SlightlyDazed/lokogad/docs/images/workflow.png

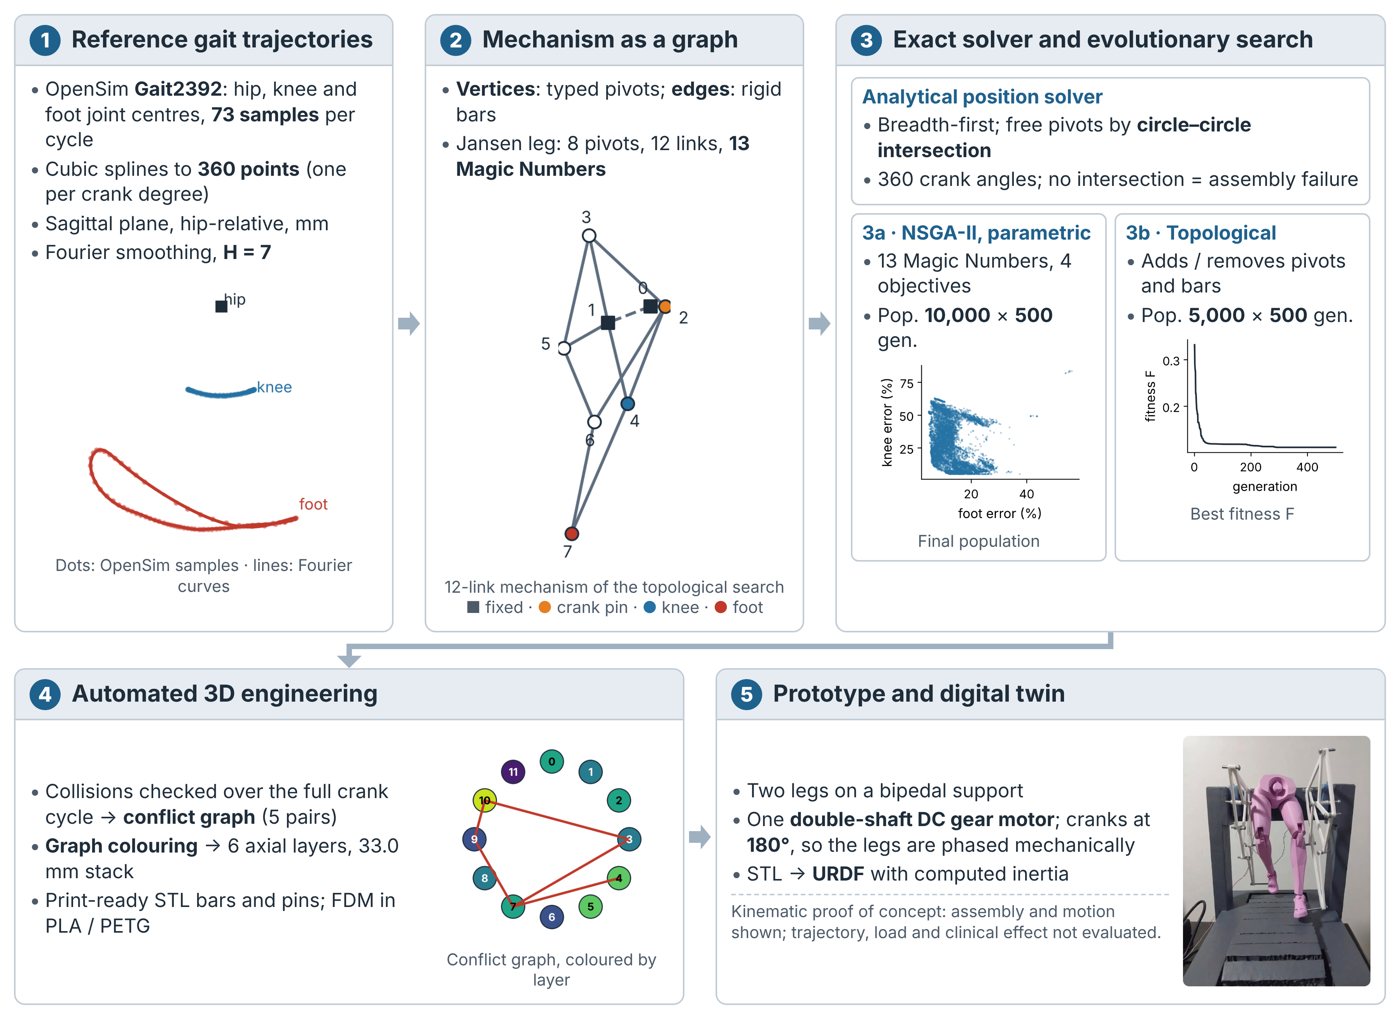
docs/images/workflow.png
