SlightlyDazed/lokogad/mechanism/theo_jansen_animation.gif

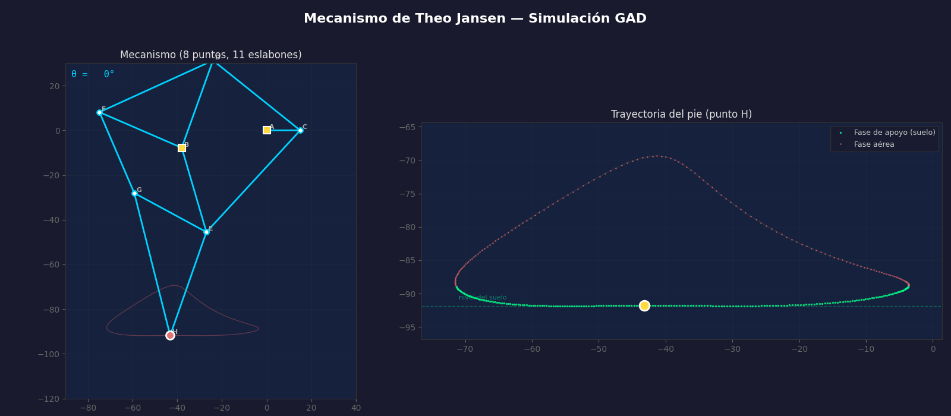
mechanism/theo_jansen_animation.gif
