SlightlyDazed/lokogad/opensim_extraction/gait_foot_trajectory.png

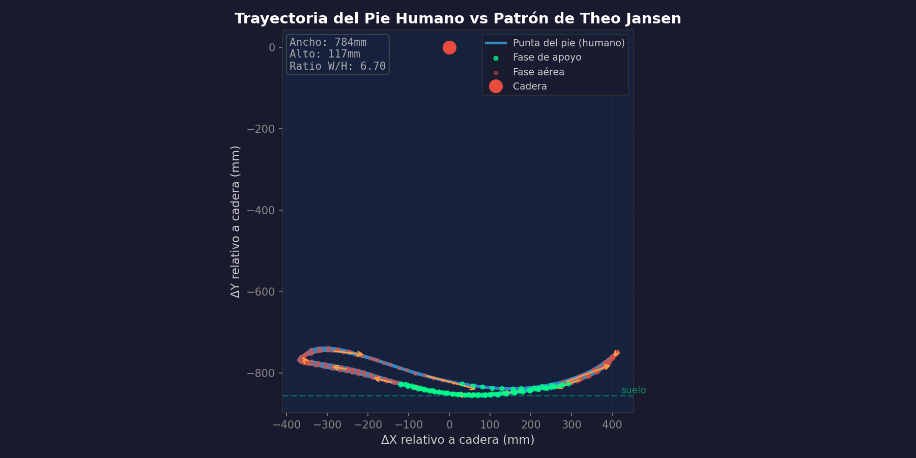
opensim_extraction/gait_foot_trajectory.png
