SlightlyDazed/lokogad/opensim_extraction/gait_spatial_trajectories.png

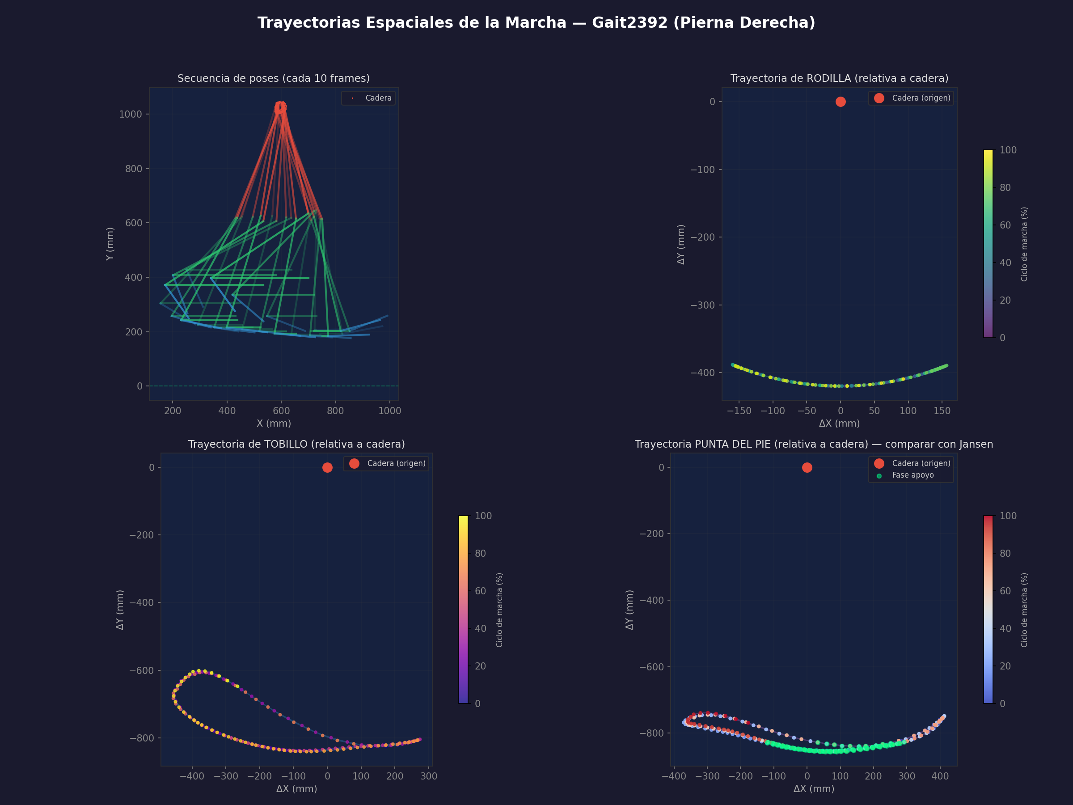
opensim_extraction/gait_spatial_trajectories.png
