SlightlyDazed/lokogad/opensim_extraction/gait_trajectories.png

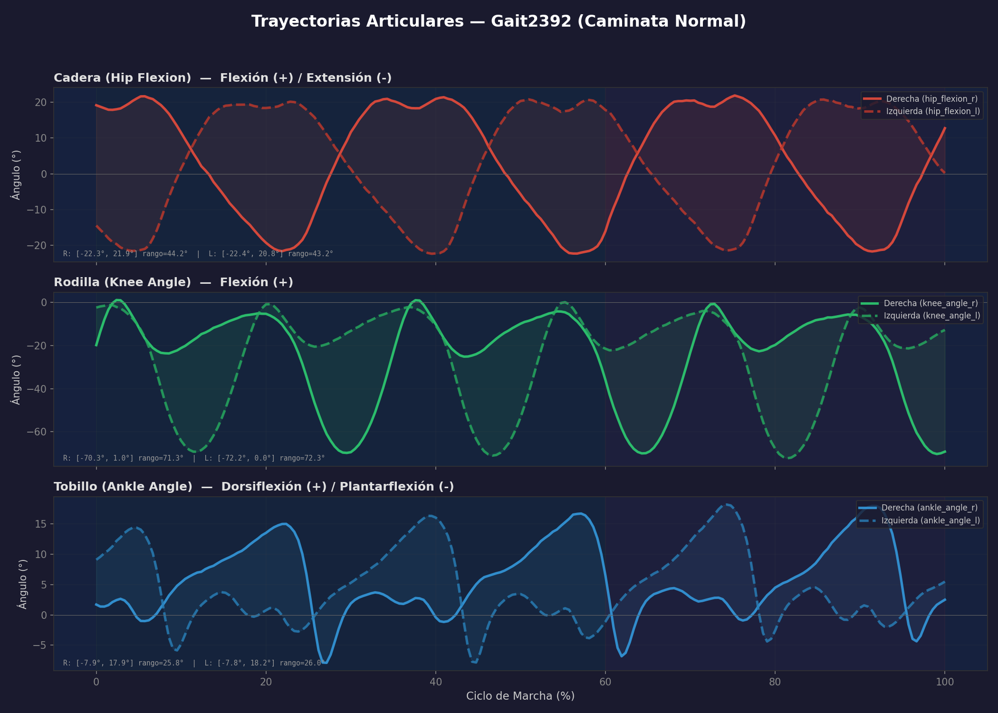
opensim_extraction/gait_trajectories.png
