SlightlyDazed/lokogad/results/paper_figures/fig2_magic_numbers.png

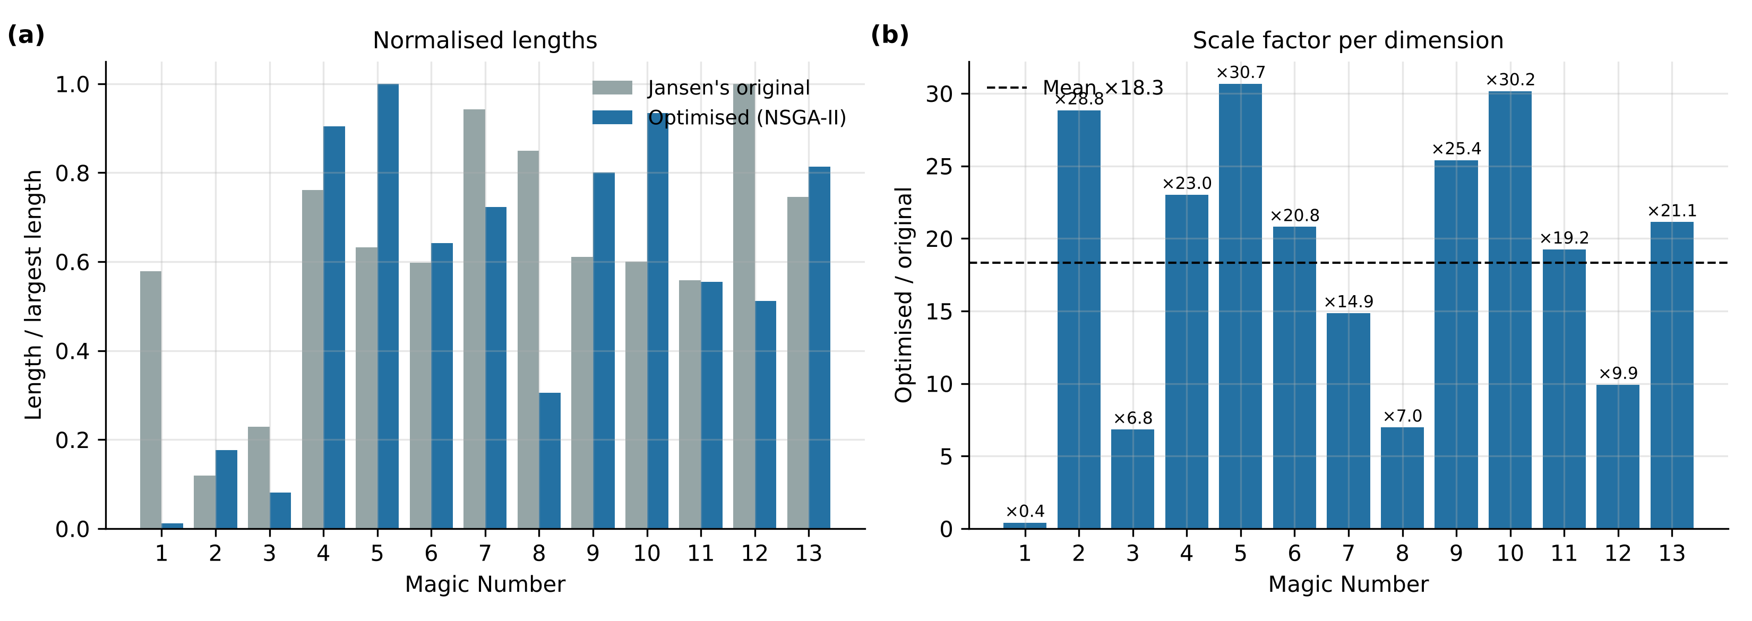
results/paper_figures/fig2_magic_numbers.png
