SlightlyDazed/lokogad/results/paper_figures/fig3_pareto_front.png

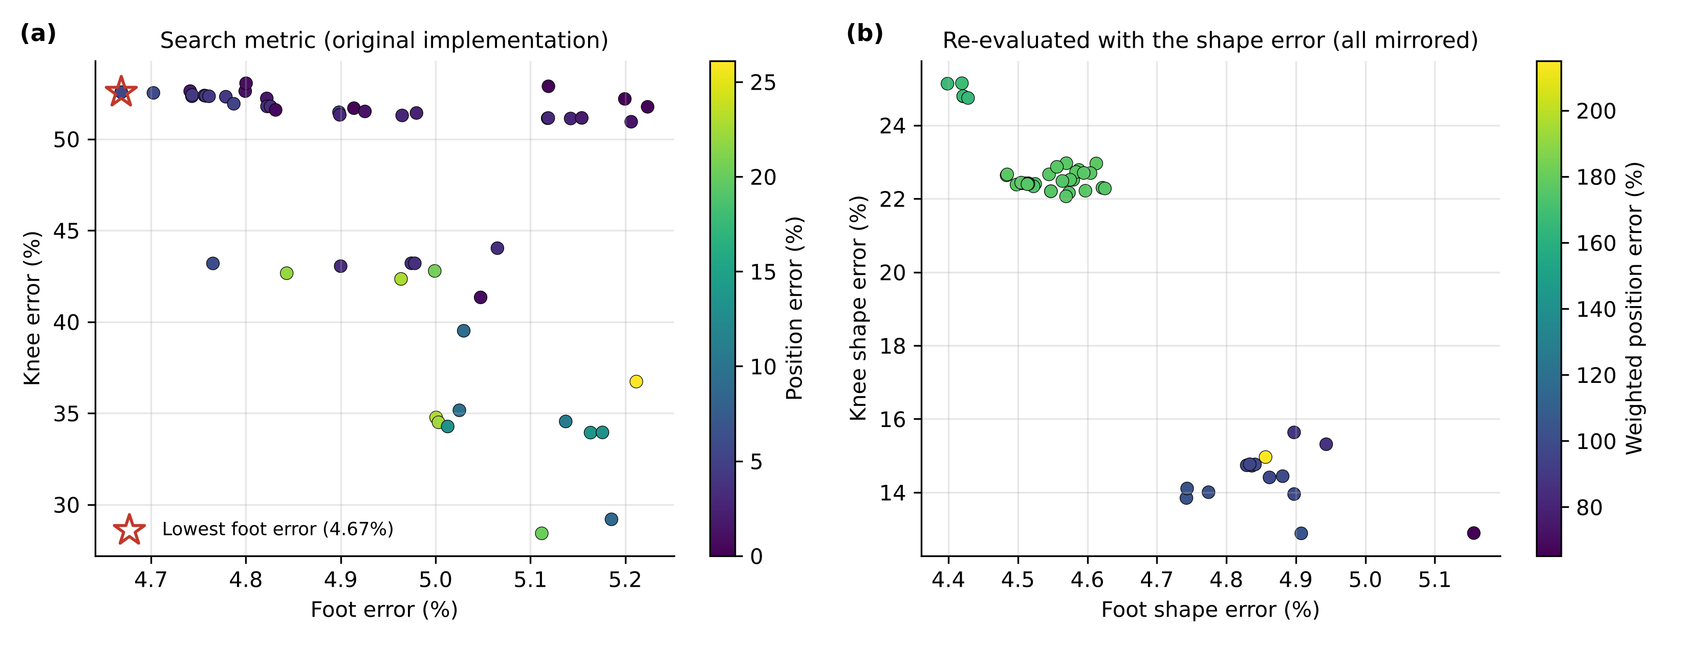
results/paper_figures/fig3_pareto_front.png
