SlightlyDazed/lokogad/results/paper_figures/fig4_z_layers.png

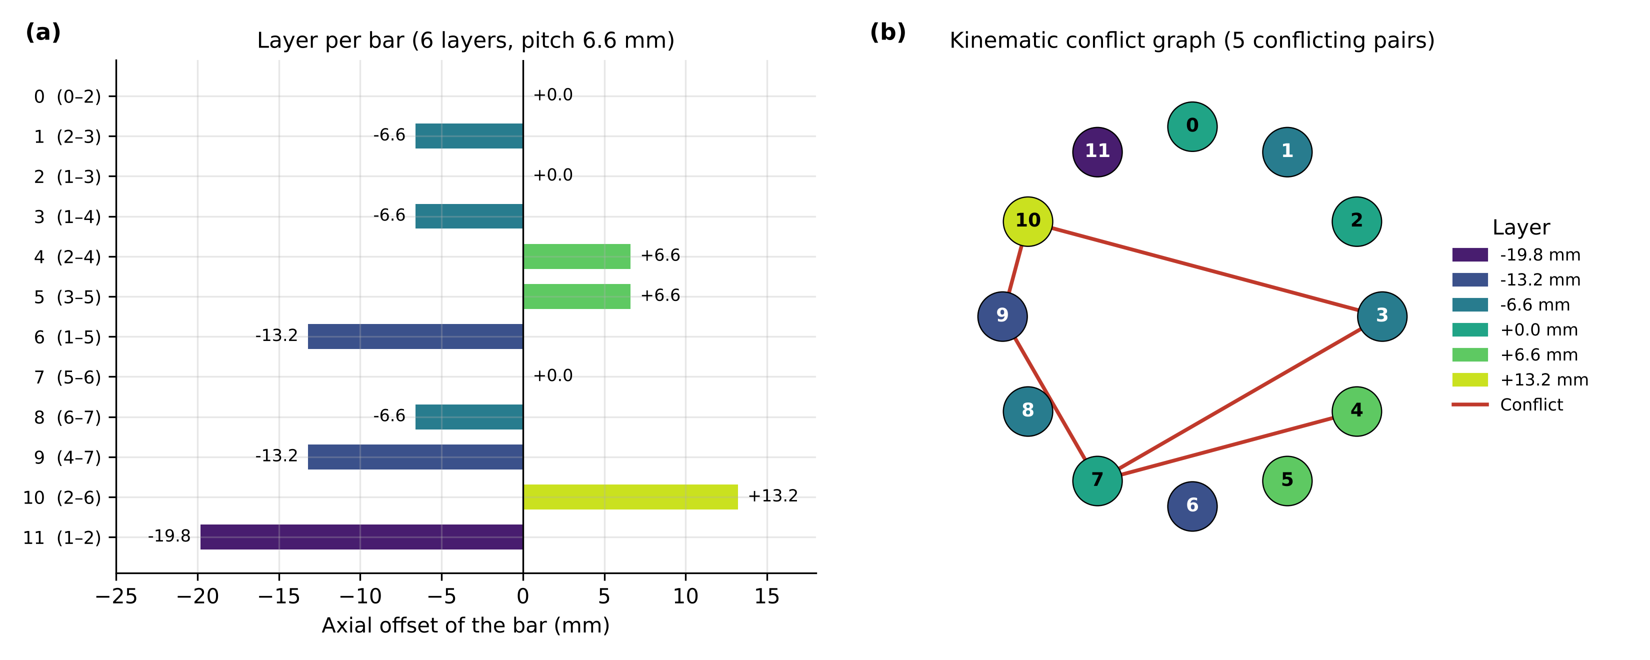
results/paper_figures/fig4_z_layers.png
