SlightlyDazed/lokogad/results/paper_figures/fig_gait_sequence_3d.png

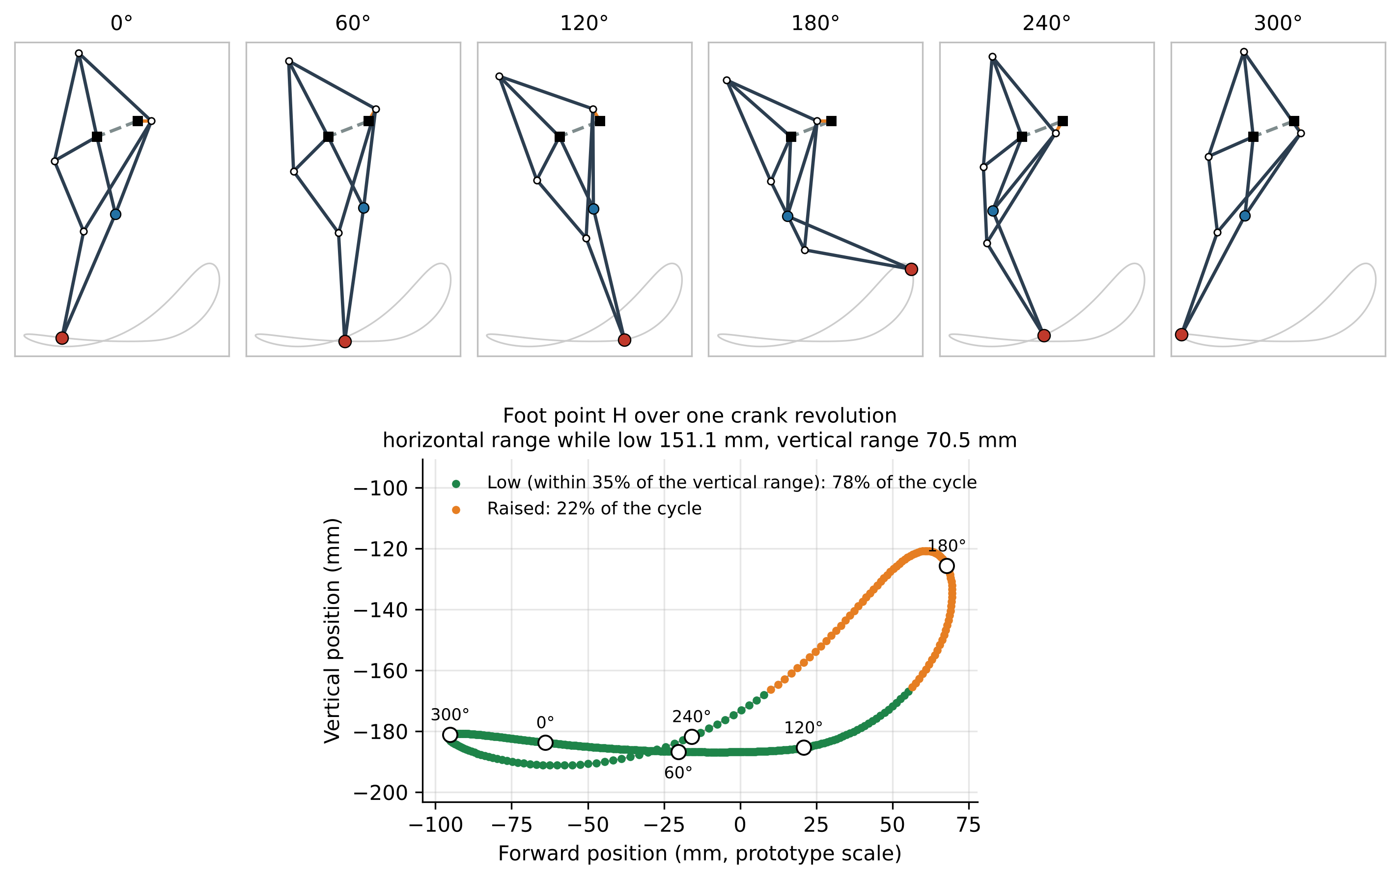
results/paper_figures/fig_gait_sequence_3d.png
