SlightlyDazed/lokogad/results/paper_figures/figconvergence.png

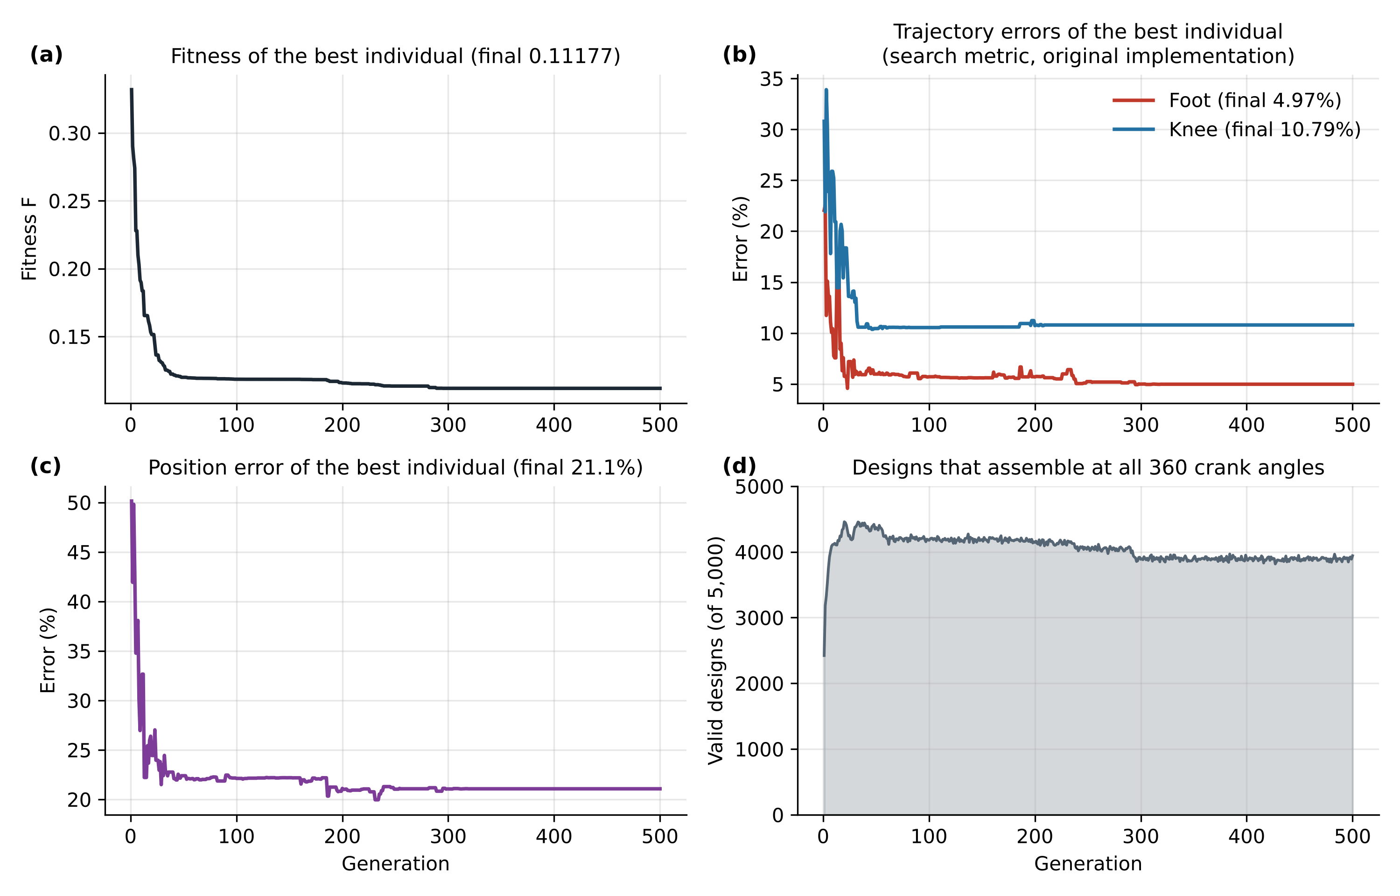
results/paper_figures/figconvergence.png
