SlightlyDazed/lokogad/snap_joint/snap_joint_assembly.step

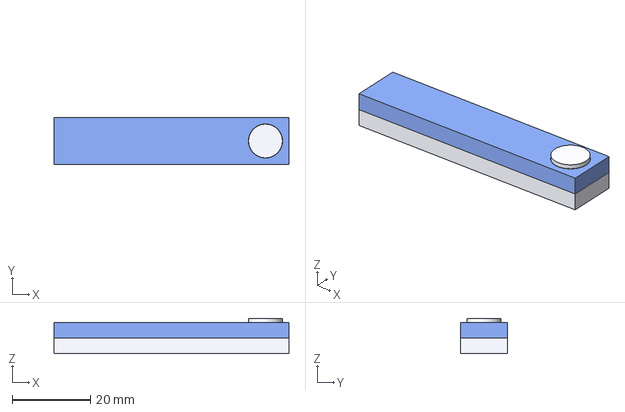
[picture p34: CAD file, 2026-10-27]
snap_joint/snap_joint_assembly.step
60.0 x 12.0 x 9.00 mm
link_A
link_B
