SlightlyDazed/lokogad/mechanism/meshes/link_DF.step

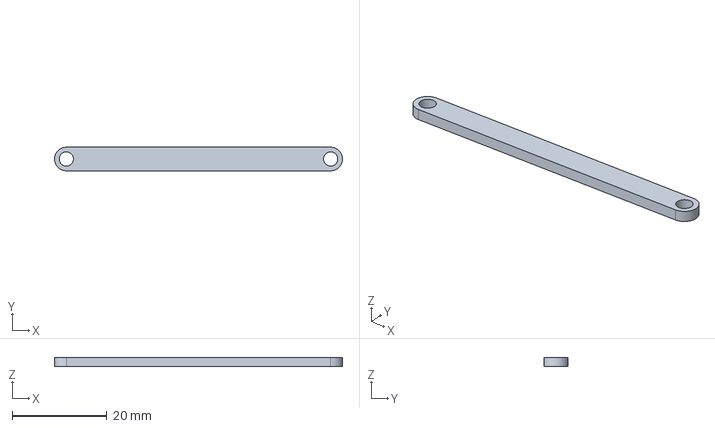
[picture p35: CAD file, 2026-10-27]
mechanism/meshes/link_DF.step
60.8 x 5.00 x 2.00 mm
