SlightlyDazed/lokogad/results/exported/candidate_001/meshes/crank.step

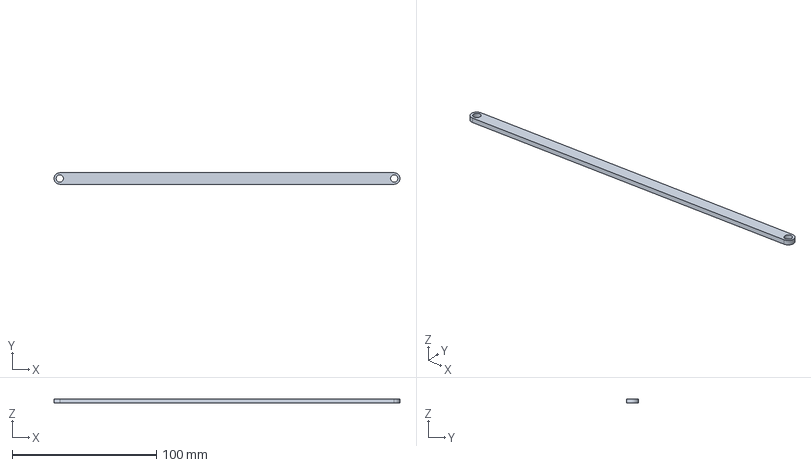
[picture p36: CAD file, 2026-10-27]
results/exported/candidate_001/meshes/crank.step
239.5 x 8.00 x 3.00 mm
