SlightlyDazed/lokogad/results/exported/candidate_002/meshes/crank.step

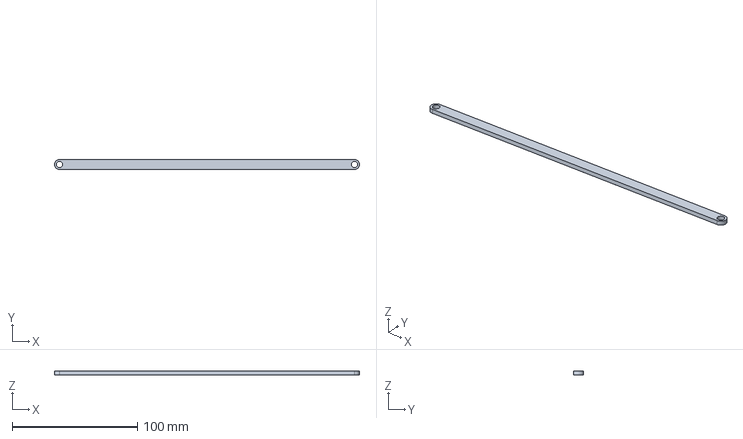
[picture p37: CAD file, 2026-10-27]
results/exported/candidate_002/meshes/crank.step
243.2 x 8.00 x 3.00 mm
