SlightlyDazed/lokogad/results/exported/candidate_003/meshes/link_FG.step

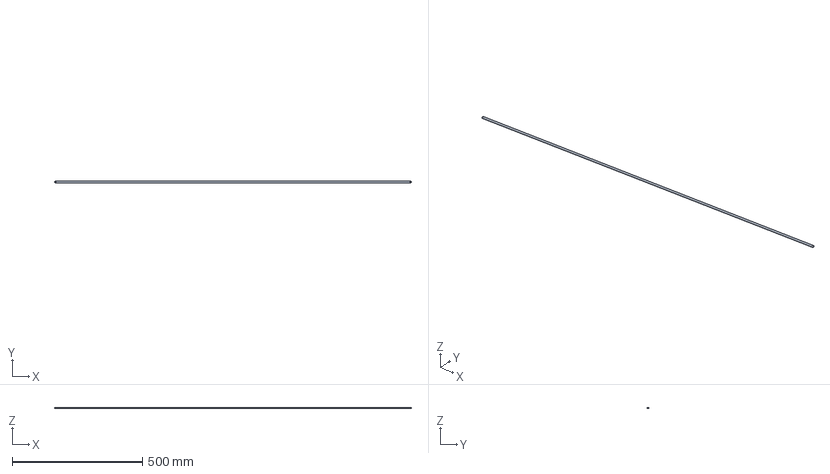
[picture p38: CAD file, 2026-10-27]
results/exported/candidate_003/meshes/link_FG.step
1368.1 x 8.00 x 3.00 mm
