SlightlyDazed/lokogad/results/exported/candidate_004/meshes/link_BF.step

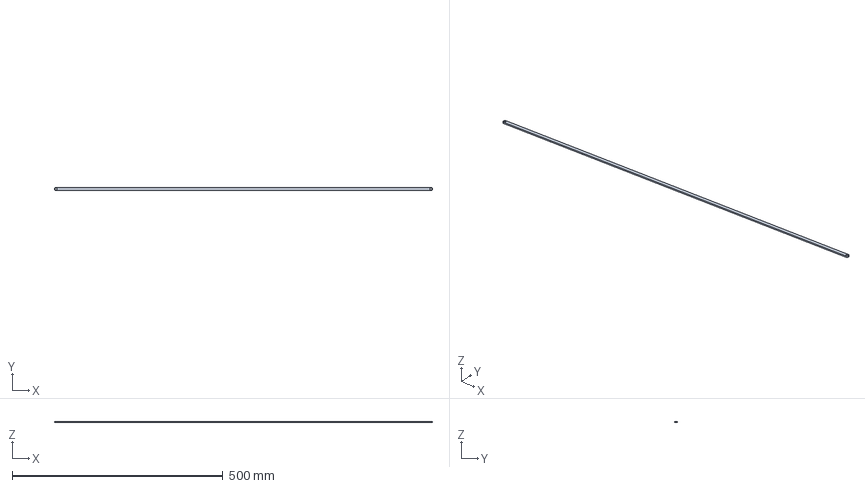
[picture p39: CAD file, 2026-10-27]
results/exported/candidate_004/meshes/link_BF.step
897.1 x 8.00 x 3.00 mm
