SlightlyDazed/lokogad/results/exported/candidate_005/meshes/chassis.step

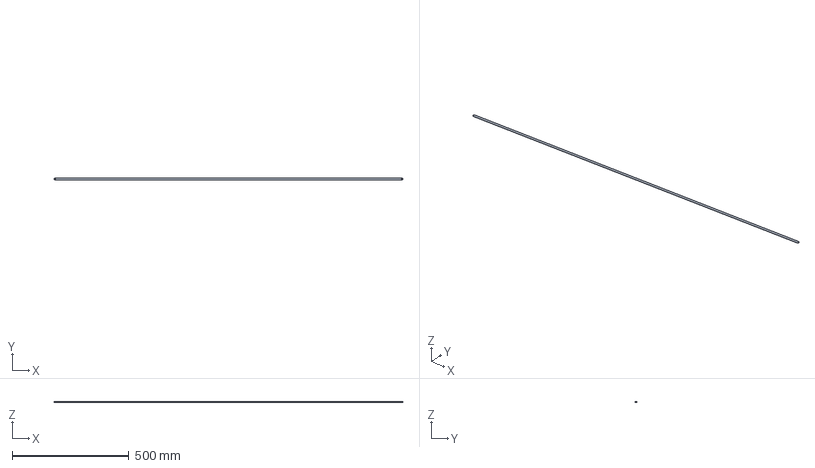
[picture p40: CAD file, 2026-10-27]
results/exported/candidate_005/meshes/chassis.step
1493.4 x 8.00 x 3.00 mm
