SlightlyDazed/lokogad/results/stl_for_print/barras_redim_1.25x/BARRA_06__N1-N5__52mm__capa-2_ESCALADA_1.25x.stl

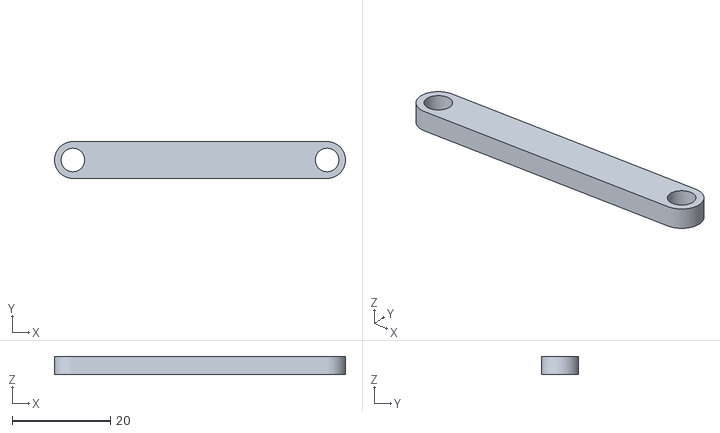
[picture p41: CAD file, 2026-10-27]
results/stl_for_print/barras_redim_1.25x/BARRA_06__N1-N5__52mm__capa-2_ESCALADA_1.25x.stl
59.3 x 7.50 x 3.75
