SlightlyDazed/lokogad/results/stl_for_print/evolved_thick/pin_01_ground_h82mm_z+0mm.stl

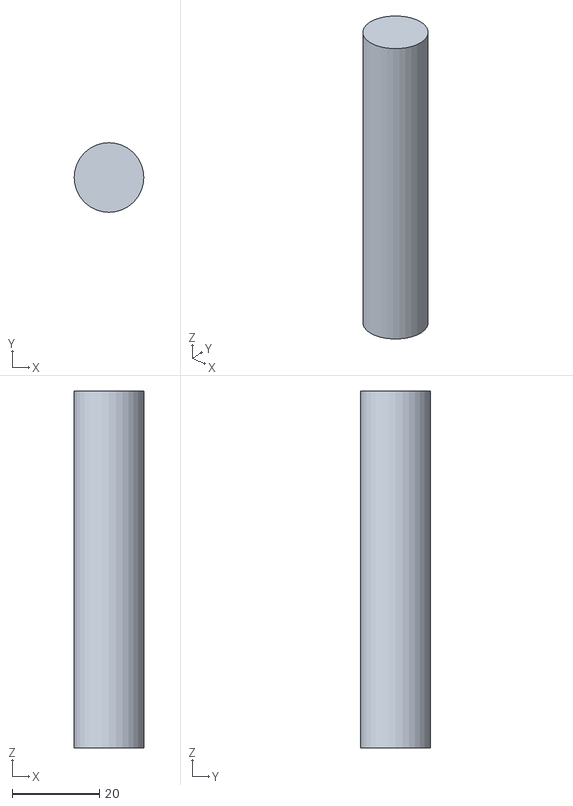
[picture p42: CAD file, 2026-10-27]
results/stl_for_print/evolved_thick/pin_01_ground_h82mm_z+0mm.stl
16.0 x 16.0 x 82.0
