SlightlyDazed/lokogad/results/stl_for_print/print_ready_250mm/PIN_05__libre__h23mm.stl

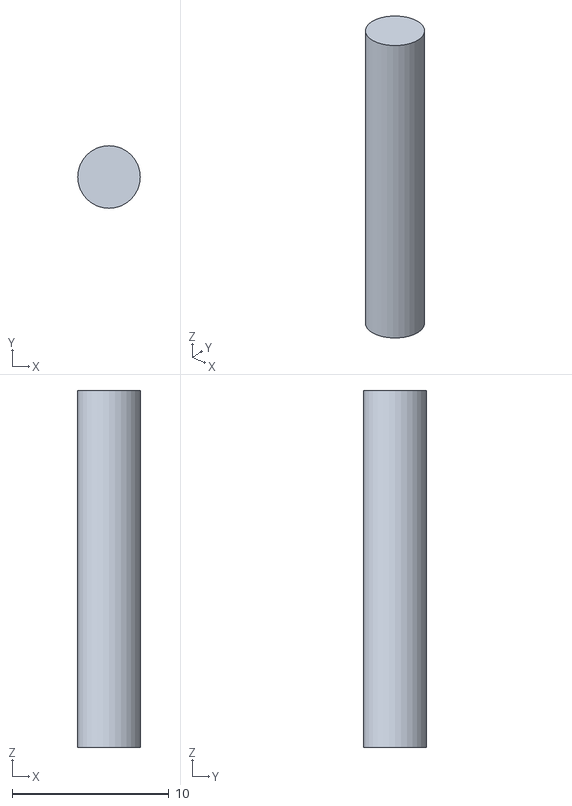
[picture p43: CAD file, 2026-10-27]
results/stl_for_print/print_ready_250mm/PIN_05__libre__h23mm.stl
4.00 x 4.00 x 22.8
