SlightlyDazed/lokogad/snap_joint/link_A.step

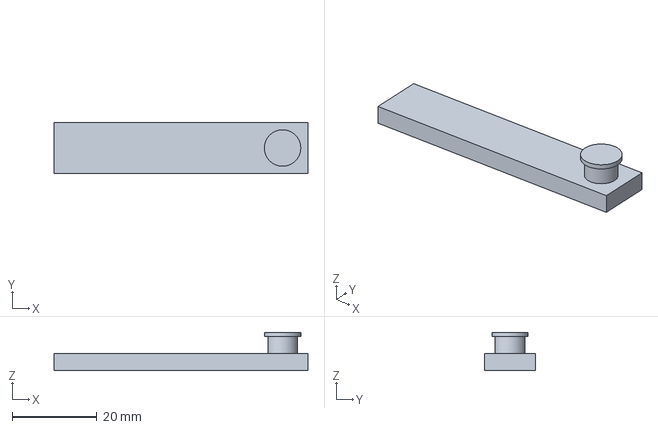
[picture p44: CAD file, 2026-10-27]
snap_joint/link_A.step
60.0 x 12.0 x 9.00 mm
