SlightlyDazed/lokogad/mechanism/meshes/link_BE.step

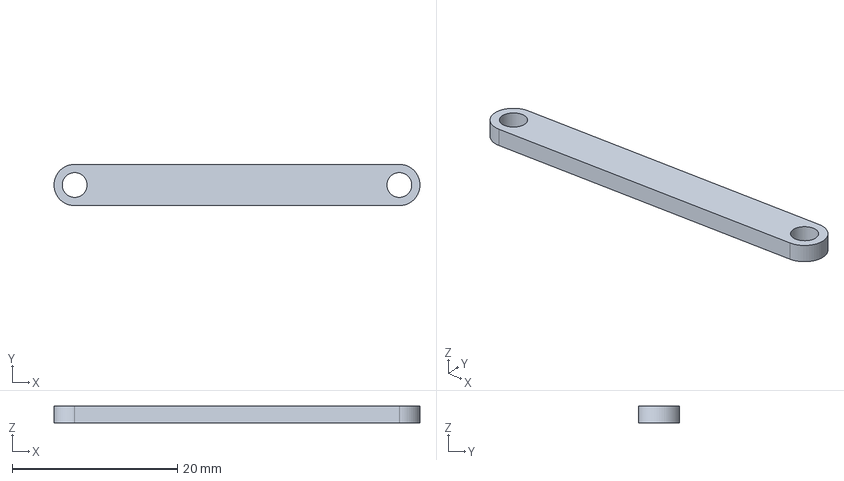
[picture p45: CAD file, 2026-10-27]
mechanism/meshes/link_BE.step
44.3 x 5.00 x 2.00 mm
