SlightlyDazed/lokogad/results/exported/candidate_001/meshes/link_FG.step

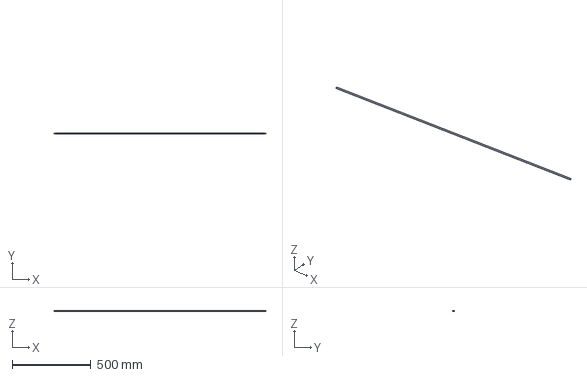
[picture p46: CAD file, 2026-10-27]
results/exported/candidate_001/meshes/link_FG.step
1348.0 x 8.00 x 3.00 mm
