SlightlyDazed/lokogad/results/exported/candidate_003/meshes/link_BF.step

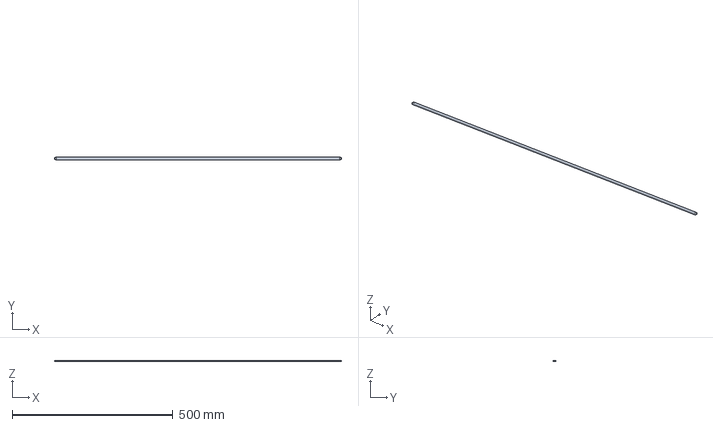
[picture p47: CAD file, 2026-10-27]
results/exported/candidate_003/meshes/link_BF.step
892.2 x 8.00 x 3.00 mm
