SlightlyDazed/lokogad/results/exported/candidate_004/meshes/link_CE.step

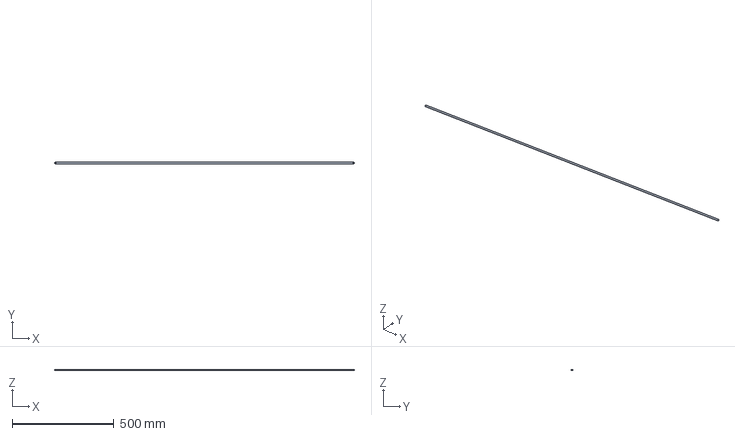
[picture p48: CAD file, 2026-10-27]
results/exported/candidate_004/meshes/link_CE.step
1475.8 x 8.00 x 3.00 mm
