SlightlyDazed/lokogad/results/exported/candidate_005/meshes/link_DF.step

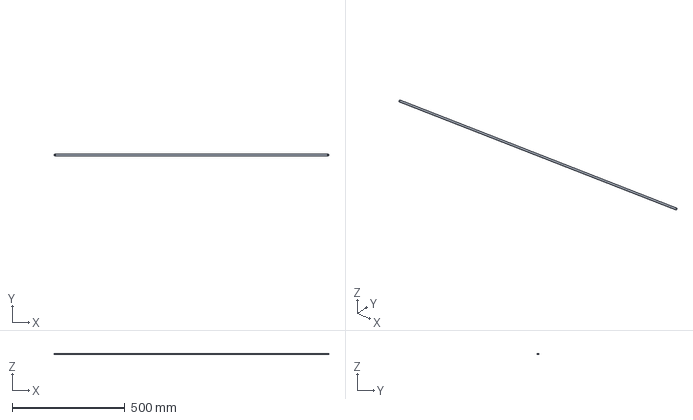
[picture p49: CAD file, 2026-10-27]
results/exported/candidate_005/meshes/link_DF.step
1221.2 x 8.00 x 3.00 mm
