SlightlyDazed/lokogad/results/stl_for_print/barras_redim_1.25x/BARRA_01__N2-N3__105mm__capa-1_ESCALADA_1.25x.stl

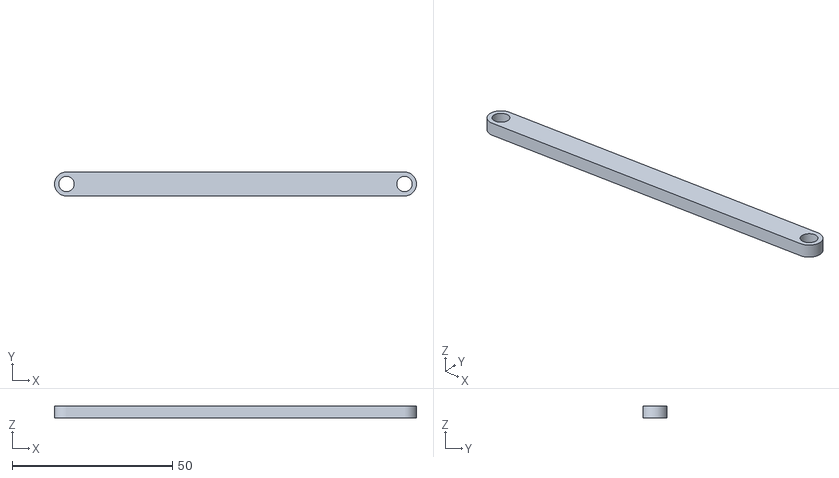
[picture p50: CAD file, 2026-10-27]
results/stl_for_print/barras_redim_1.25x/BARRA_01__N2-N3__105mm__capa-1_ESCALADA_1.25x.stl
112.8 x 7.50 x 3.75
