SlightlyDazed/lokogad/results/stl_for_print/evolved_thick/bar_01_n2-n3_L492mm_z-18mm.stl

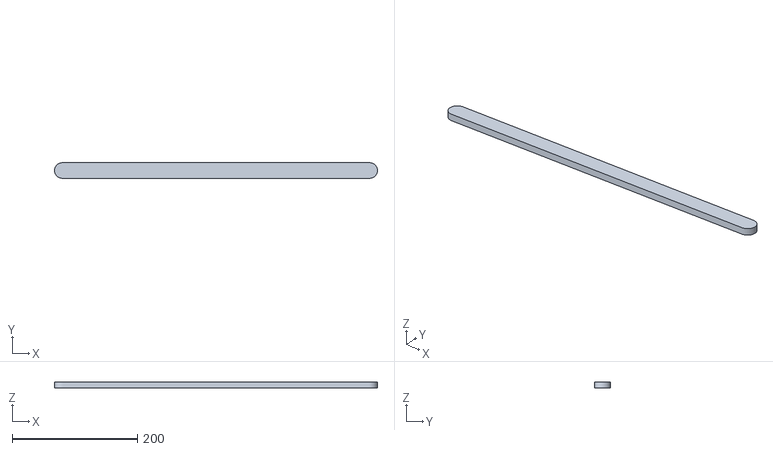
[picture p51: CAD file, 2026-10-27]
results/stl_for_print/evolved_thick/bar_01_n2-n3_L492mm_z-18mm.stl
516.6 x 25.0 x 10.0
