SlightlyDazed/lokogad/results/stl_for_print/print_ready_250mm/PIN_07__pie_efector__h10mm.stl

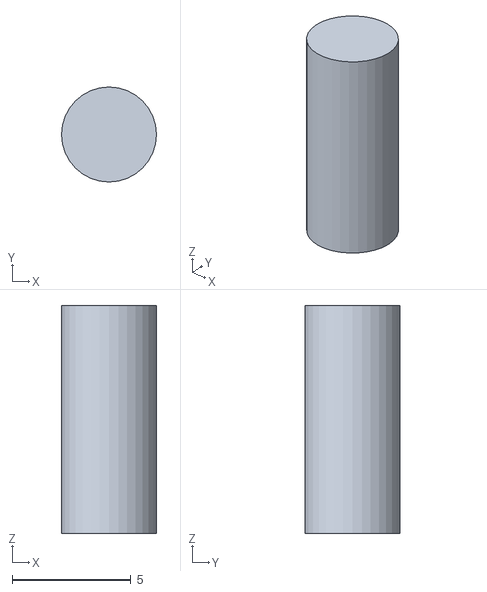
[picture p52: CAD file, 2026-10-27]
results/stl_for_print/print_ready_250mm/PIN_07__pie_efector__h10mm.stl
4.00 x 4.00 x 9.60
