SlightlyDazed/lokogad/snap_joint/link_B.step

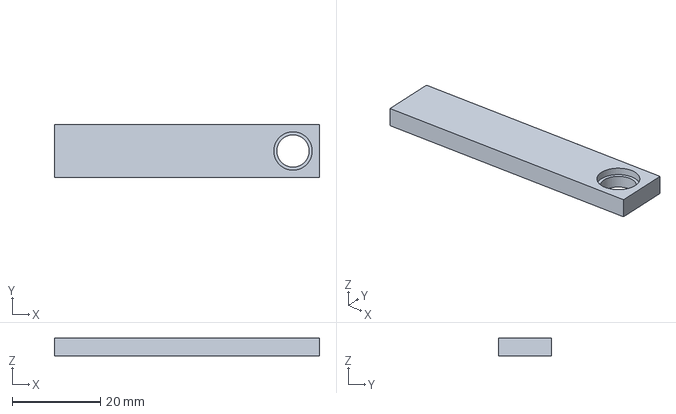
[picture p53: CAD file, 2026-10-27]
snap_joint/link_B.step
60.0 x 12.0 x 4.00 mm
