SlightlyDazed/lokogad/mechanism/meshes/link_CD.step

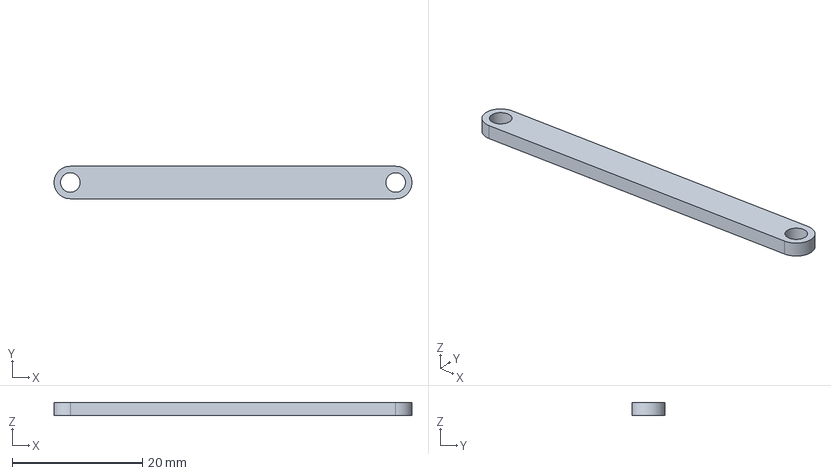
[picture p54: CAD file, 2026-10-27]
mechanism/meshes/link_CD.step
55.0 x 5.00 x 2.00 mm
