SlightlyDazed/lokogad/results/stl_for_print/barras_redim_1.25x/BARRA_10__N2-N6__137mm__capa+2_ESCALADA_1.25x.stl

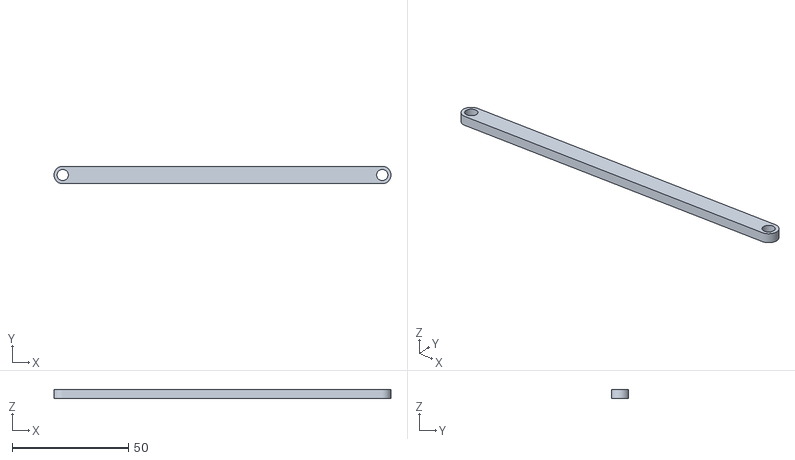
[picture p55: CAD file, 2026-10-27]
results/stl_for_print/barras_redim_1.25x/BARRA_10__N2-N6__137mm__capa+2_ESCALADA_1.25x.stl
144.7 x 7.50 x 3.75
