SlightlyDazed/lokogad/results/stl_for_print/evolved_thick/pin_04_output_knee_h46mm_z+0mm.stl

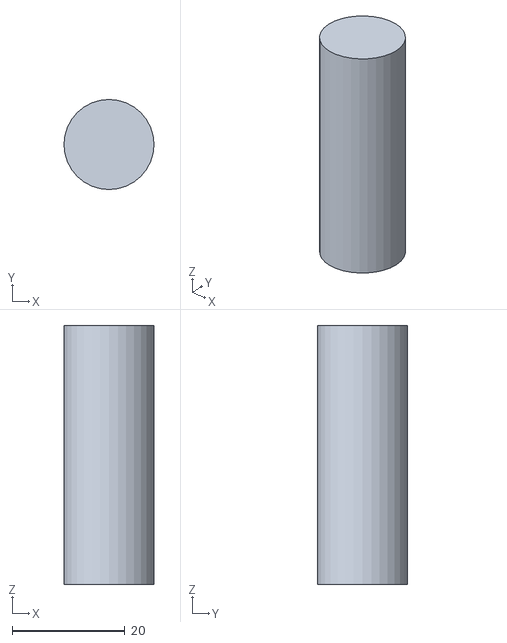
[picture p56: CAD file, 2026-10-27]
results/stl_for_print/evolved_thick/pin_04_output_knee_h46mm_z+0mm.stl
16.0 x 16.0 x 46.0
