SlightlyDazed/lokogad/results/stl_for_print/print_ready_250mm/BARRA_11__N1-N2__18mm__capa-3_ESCALADA_0.6cm.stl

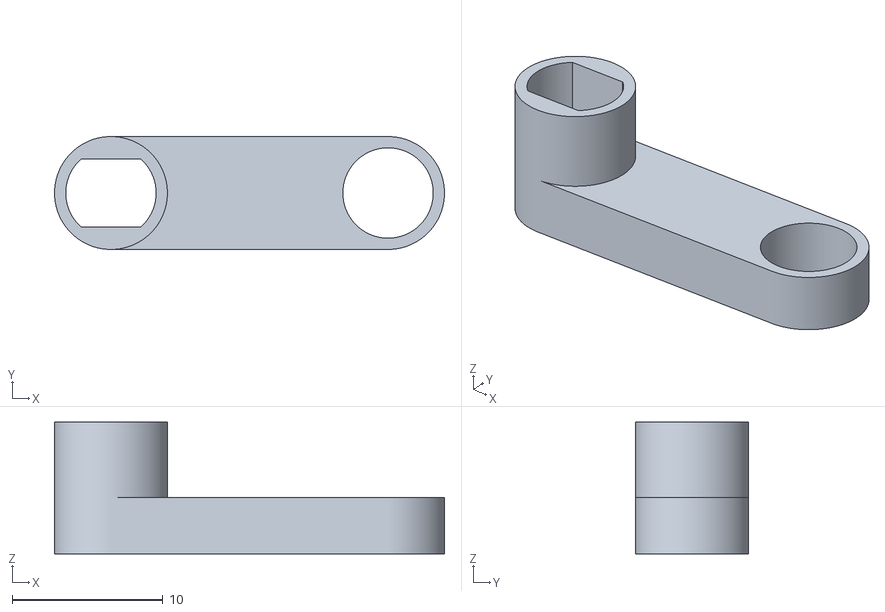
[picture p57: CAD file, 2026-10-27]
results/stl_for_print/print_ready_250mm/BARRA_11__N1-N2__18mm__capa-3_ESCALADA_0.6cm.stl
25.9 x 7.50 x 8.75
