SlightlyDazed/lokogad/mechanism/meshes/crank_AC.step

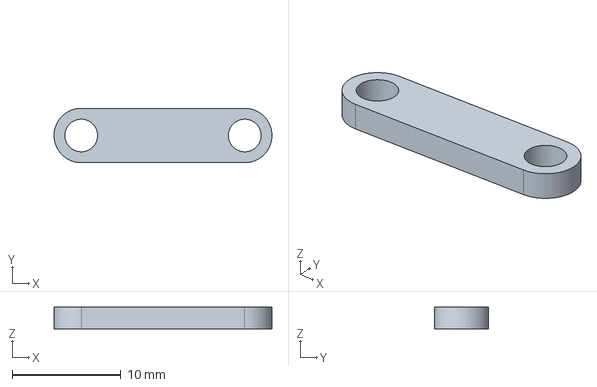
[picture p58: CAD file, 2026-10-27]
mechanism/meshes/crank_AC.step
20.0 x 5.00 x 2.00 mm
