SlightlyDazed/lokogad/results/exported/candidate_004/meshes/link_BE.step

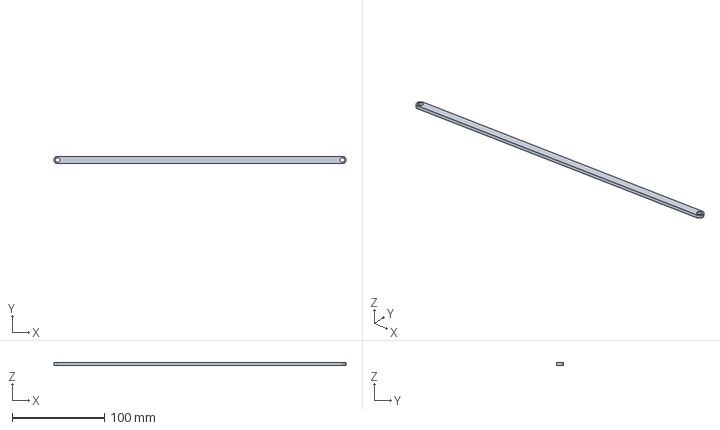
[picture p59: CAD file, 2026-10-27]
results/exported/candidate_004/meshes/link_BE.step
316.8 x 8.00 x 3.00 mm
