SlightlyDazed/lokogad/results/exported/candidate_005/meshes/link_EG.step

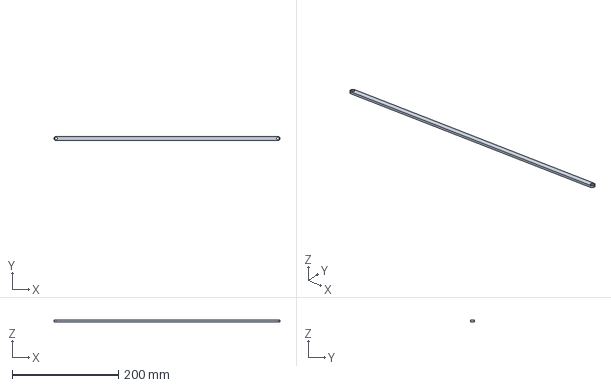
[picture p60: CAD file, 2026-10-27]
results/exported/candidate_005/meshes/link_EG.step
424.5 x 8.00 x 3.00 mm
