SlightlyDazed/lokogad/results/stl_for_print/barras_redim_1.25x/BARRA_02__N1-N3__91mm__capa+0_ESCALADA_1.25x.stl

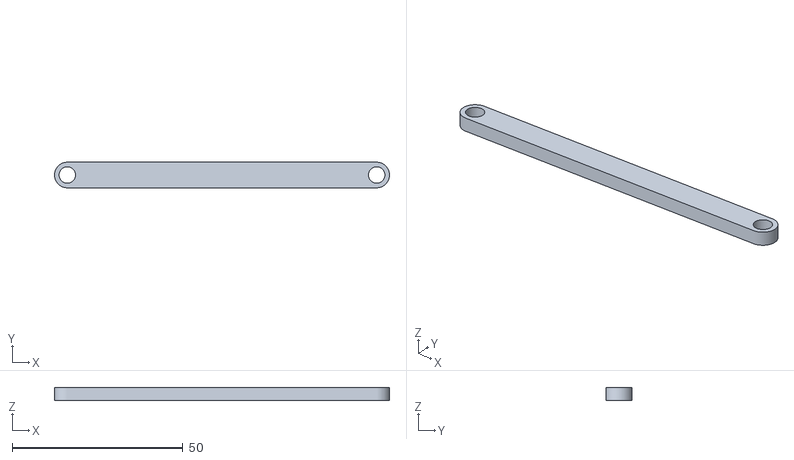
[picture p61: CAD file, 2026-10-27]
results/stl_for_print/barras_redim_1.25x/BARRA_02__N1-N3__91mm__capa+0_ESCALADA_1.25x.stl
98.1 x 7.50 x 3.75
