SlightlyDazed/lokogad/mechanism/meshes/link_GH.step

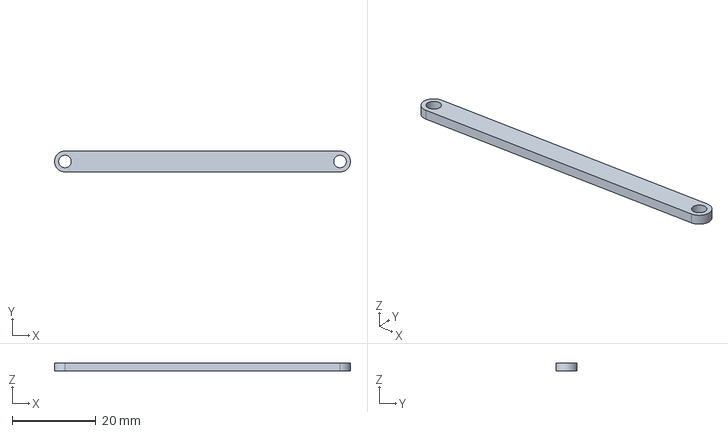
[picture p62: CAD file, 2026-10-27]
mechanism/meshes/link_GH.step
70.7 x 5.00 x 2.00 mm
