SlightlyDazed/lokogad/results/exported/candidate_003/meshes/link_EG.step

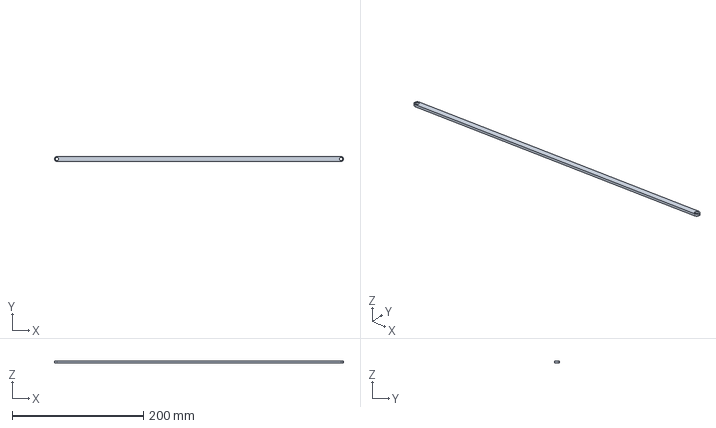
[picture p63: CAD file, 2026-10-27]
results/exported/candidate_003/meshes/link_EG.step
440.1 x 8.00 x 3.00 mm
