SlightlyDazed/lokogad/results/stl_for_print/barras_redim_1.25x/BARRA_00__N0-N2__16mm__capa+0_ESCALADA_1.25x.stl

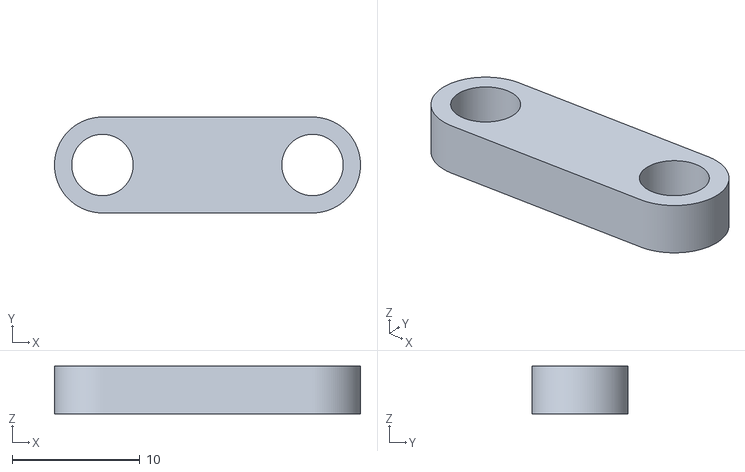
[picture p64: CAD file, 2026-10-27]
results/stl_for_print/barras_redim_1.25x/BARRA_00__N0-N2__16mm__capa+0_ESCALADA_1.25x.stl
23.9 x 7.50 x 3.75
