SlightlyDazed/lokogad/results/stl_for_print/evolved_thick/pin_07_output_foot_h28mm_z-9mm.stl

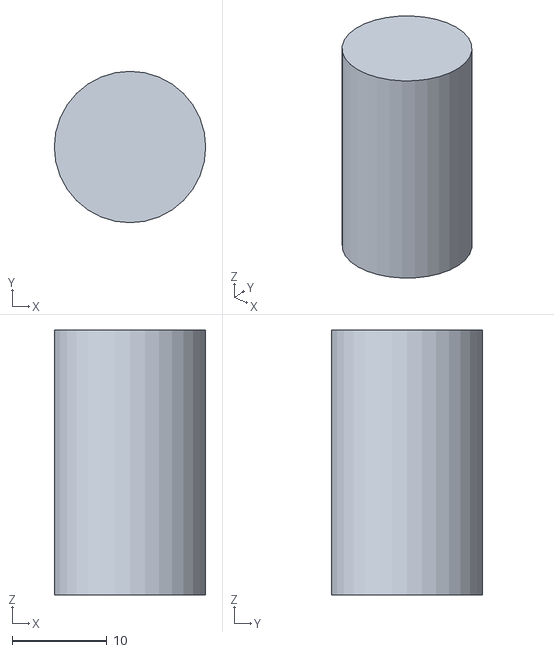
[picture p65: CAD file, 2026-10-27]
results/stl_for_print/evolved_thick/pin_07_output_foot_h28mm_z-9mm.stl
16.0 x 16.0 x 28.0
