SlightlyDazed/lokogad/results/stl_for_print/print_ready_250mm/PIN_03__libre__h16mm.stl

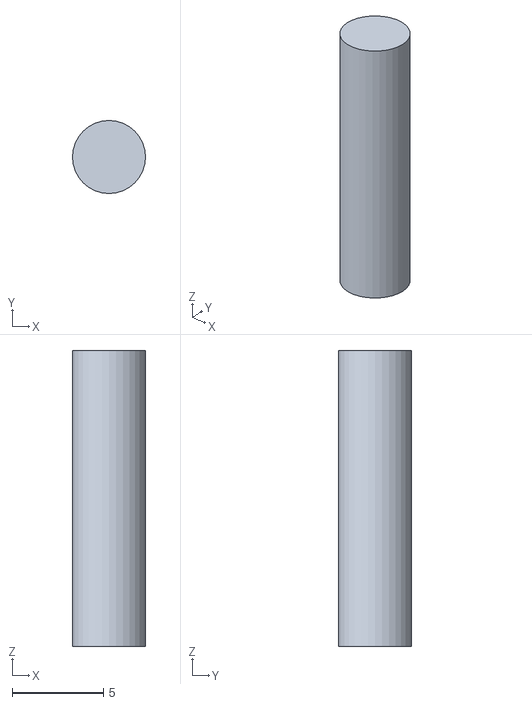
[picture p66: CAD file, 2026-10-27]
results/stl_for_print/print_ready_250mm/PIN_03__libre__h16mm.stl
4.00 x 4.00 x 16.2
