SlightlyDazed/lokogad/mechanism/meshes/link_BF.step

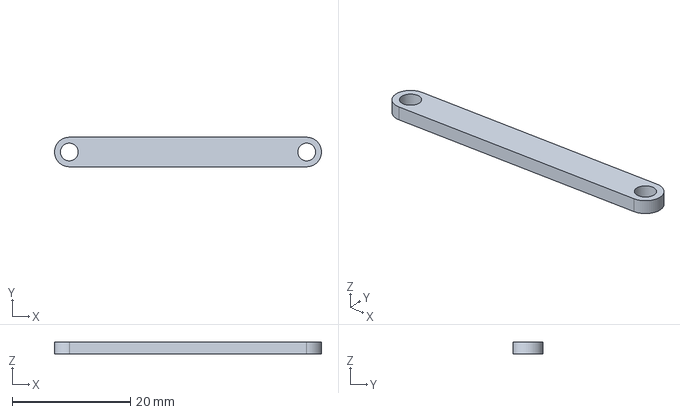
[picture p67: CAD file, 2026-10-27]
mechanism/meshes/link_BF.step
45.1 x 5.00 x 2.00 mm
