SlightlyDazed/lokogad/results/exported/candidate_002/meshes/link_EH.step

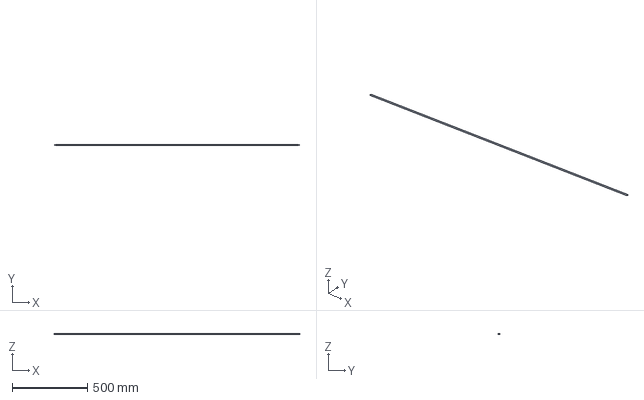
[picture p68: CAD file, 2026-10-27]
results/exported/candidate_002/meshes/link_EH.step
1628.2 x 8.00 x 3.00 mm
