SlightlyDazed/lokogad/results/exported/candidate_003/meshes/link_CD.step

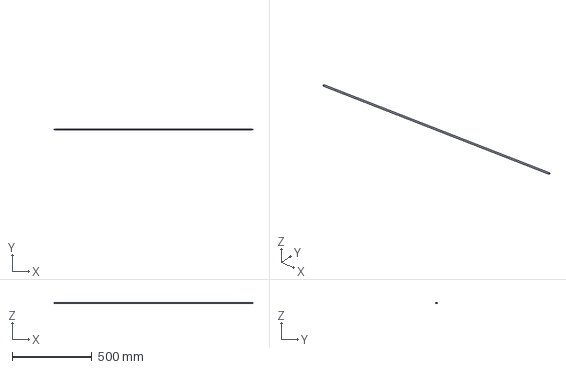
[picture p69: CAD file, 2026-10-27]
results/exported/candidate_003/meshes/link_CD.step
1250.0 x 8.00 x 3.00 mm
