SlightlyDazed/lokogad/results/exported/candidate_004/meshes/link_EG.step

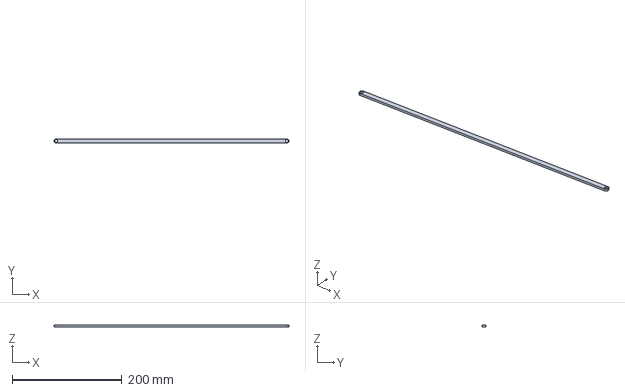
[picture p70: CAD file, 2026-10-27]
results/exported/candidate_004/meshes/link_EG.step
428.8 x 8.00 x 3.00 mm
