SlightlyDazed/lokogad/results/stl_for_print/barras_redim_1.25x/BARRA_03__N1-N4__84mm__capa-1_ESCALADA_1.25x.stl

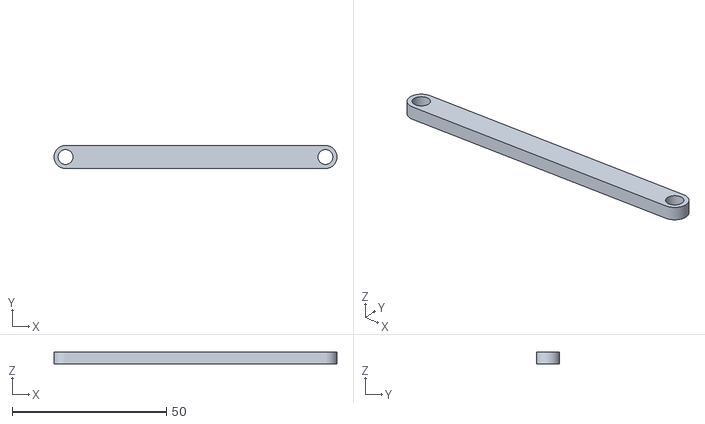
[picture p71: CAD file, 2026-10-27]
results/stl_for_print/barras_redim_1.25x/BARRA_03__N1-N4__84mm__capa-1_ESCALADA_1.25x.stl
91.7 x 7.50 x 3.75
