SlightlyDazed/lokogad/results/stl_for_print/evolved_thick/pin_00_ground_h20mm_z+0mm.stl

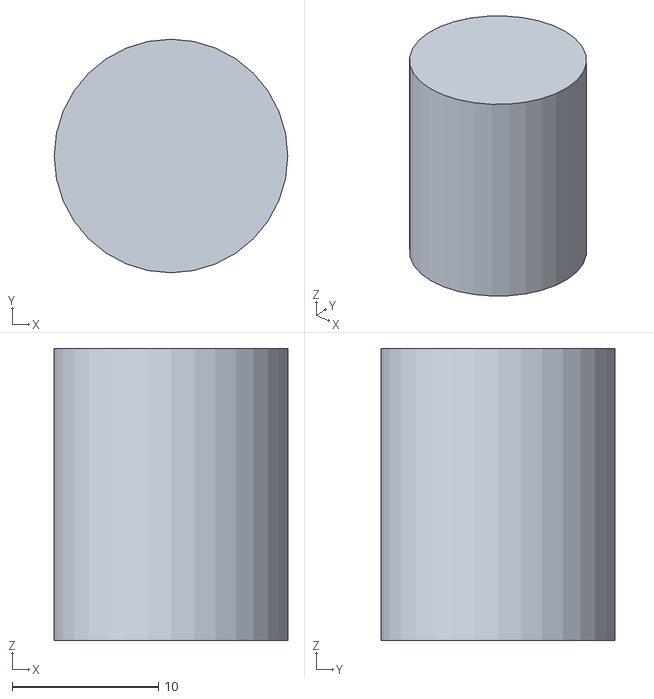
[picture p72: CAD file, 2026-10-27]
results/stl_for_print/evolved_thick/pin_00_ground_h20mm_z+0mm.stl
16.0 x 16.0 x 20.0
