SlightlyDazed/lokogad/mechanism/meshes/link_EH.step

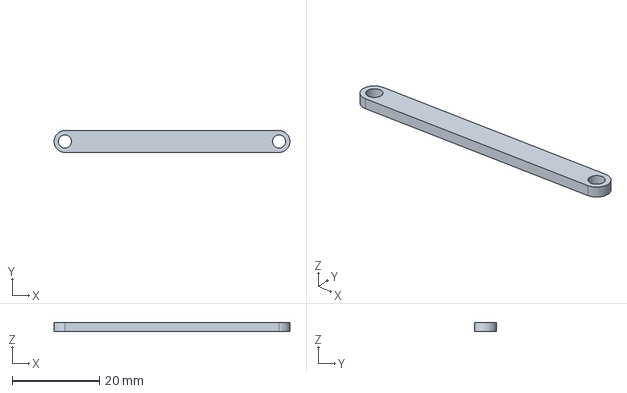
[picture p73: CAD file, 2026-10-27]
mechanism/meshes/link_EH.step
54.0 x 5.00 x 2.00 mm
