SlightlyDazed/lokogad/results/stl_for_print/evolved_thick/bar_02_n1-n3_L423mm_z+0mm.stl

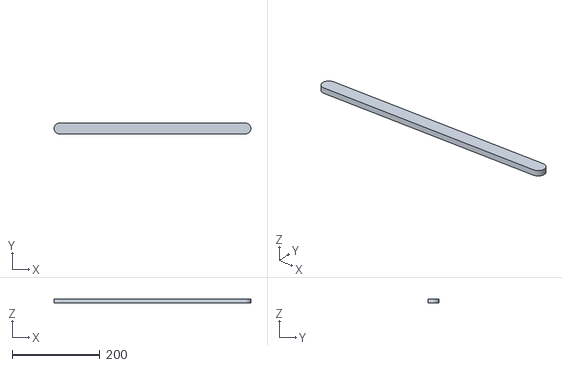
[picture p74: CAD file, 2026-10-27]
results/stl_for_print/evolved_thick/bar_02_n1-n3_L423mm_z+0mm.stl
448.0 x 25.0 x 10.0
