SlightlyDazed/lokogad/results/stl_for_print/print_ready_250mm/BARRA_11__N1-N2__15mm__capa-3.stl

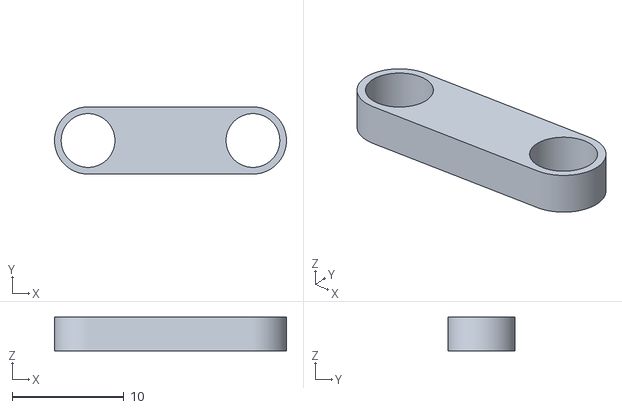
[picture p75: CAD file, 2026-10-27]
results/stl_for_print/print_ready_250mm/BARRA_11__N1-N2__15mm__capa-3.stl
20.7 x 6.00 x 3.00
