SlightlyDazed/lokogad/mechanism/meshes/link_EG.step

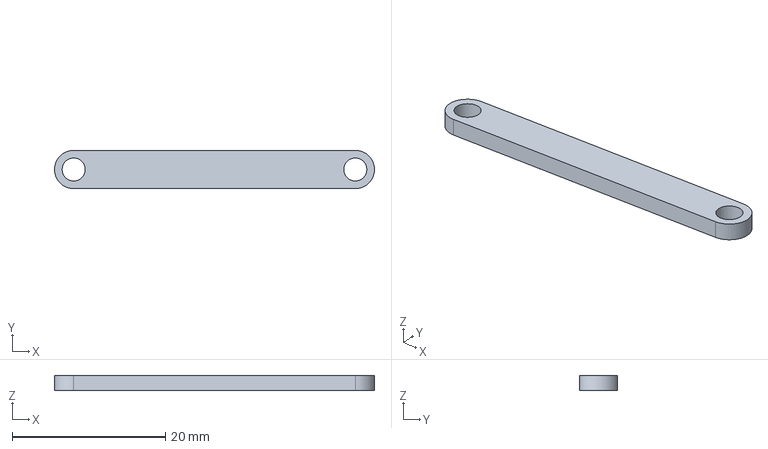
[picture p76: CAD file, 2026-10-27]
mechanism/meshes/link_EG.step
41.7 x 5.00 x 2.00 mm
