SlightlyDazed/lokogad/results/stl_for_print/barras_redim_1.25x/BRAZO_MOTOR__L67mm__hubs_d3mm__boquilla15mm.stl

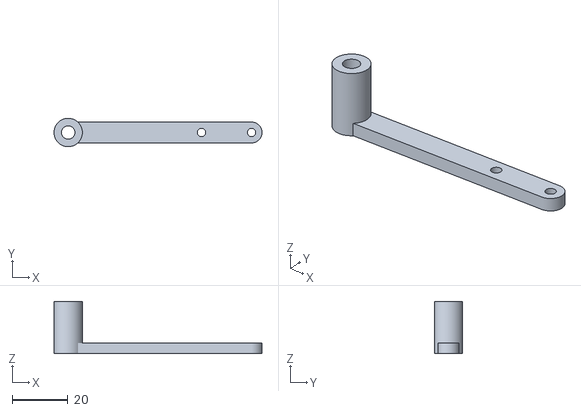
[picture p77: CAD file, 2026-10-27]
results/stl_for_print/barras_redim_1.25x/BRAZO_MOTOR__L67mm__hubs_d3mm__boquilla15mm.stl
74.8 x 10.2 x 18.8
