SlightlyDazed/lokogad/results/stl_for_print/evolved_thick/bar_10_n2-n6_L641mm_z-36mm.stl

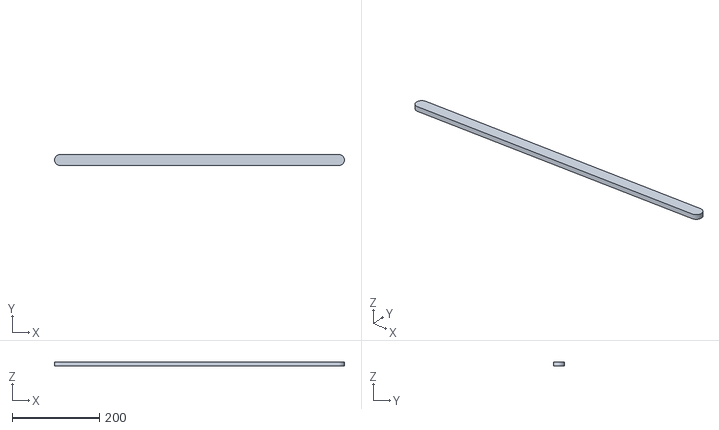
[picture p78: CAD file, 2026-10-27]
results/stl_for_print/evolved_thick/bar_10_n2-n6_L641mm_z-36mm.stl
665.7 x 25.0 x 10.0
