SlightlyDazed/lokogad/results/stl_for_print/print_ready_250mm/PIN_00__suelo_fijo__h6mm.stl

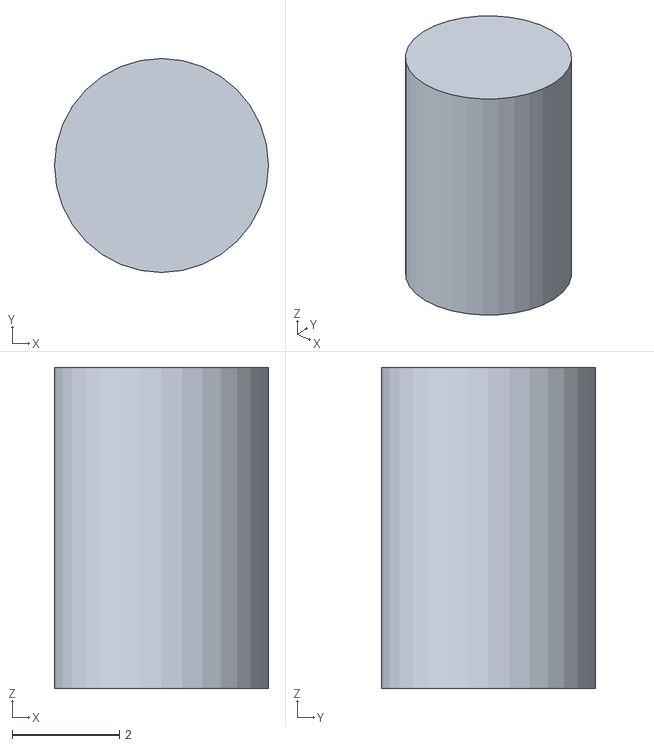
[picture p79: CAD file, 2026-10-27]
results/stl_for_print/print_ready_250mm/PIN_00__suelo_fijo__h6mm.stl
4.00 x 4.00 x 6.00
