SlightlyDazed/lokogad/mechanism/meshes/link_BD.step

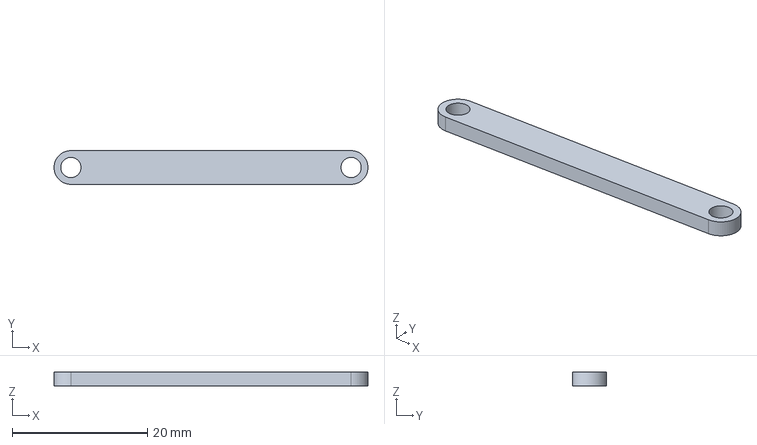
[picture p80: CAD file, 2026-10-27]
mechanism/meshes/link_BD.step
46.5 x 5.00 x 2.00 mm
