SlightlyDazed/lokogad/results/exported/candidate_005/meshes/link_BE.step

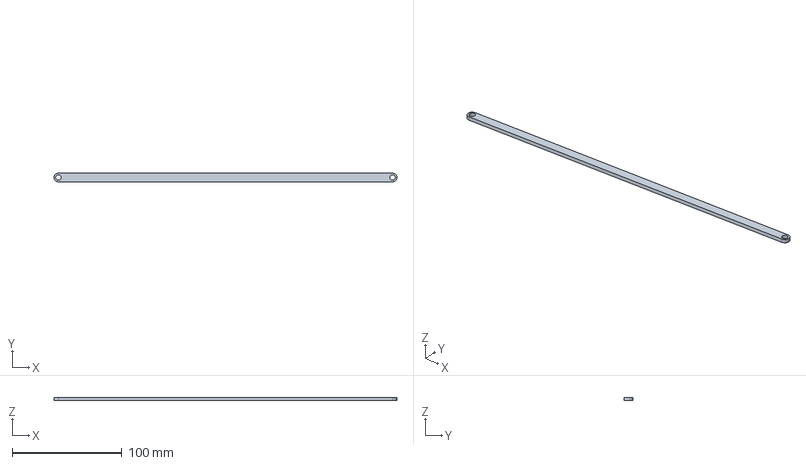
[picture p81: CAD file, 2026-10-27]
results/exported/candidate_005/meshes/link_BE.step
312.2 x 8.00 x 3.00 mm
