SlightlyDazed/lokogad/results/stl_for_print/barras_redim_1.25x/BARRA_09__N4-N7__143mm__capa-2_ESCALADA_1.25x.stl

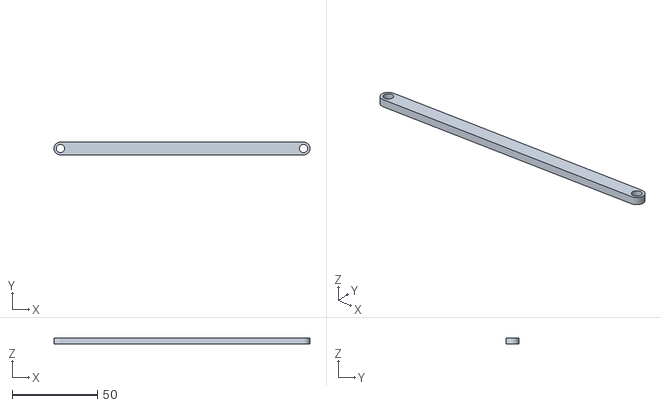
[picture p82: CAD file, 2026-10-27]
results/stl_for_print/barras_redim_1.25x/BARRA_09__N4-N7__143mm__capa-2_ESCALADA_1.25x.stl
150.4 x 7.50 x 3.75
