SlightlyDazed/lokogad/results/stl_for_print/evolved_thick/bar_00_n0-n2_L77mm_z+0mm.stl

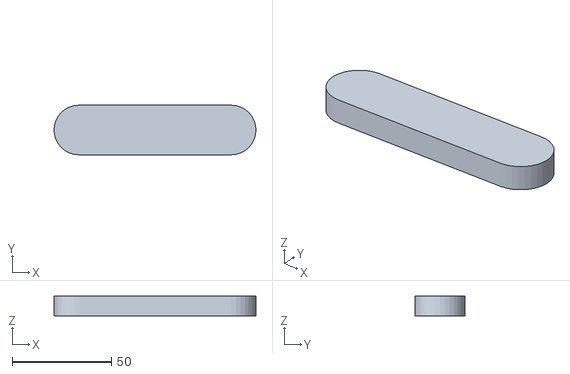
[picture p83: CAD file, 2026-10-27]
results/stl_for_print/evolved_thick/bar_00_n0-n2_L77mm_z+0mm.stl
101.7 x 25.0 x 10.0
