SlightlyDazed/lokogad/results/stl_for_print/print_ready_250mm/BARRA_00__N0-N2__13mm__capa0.stl

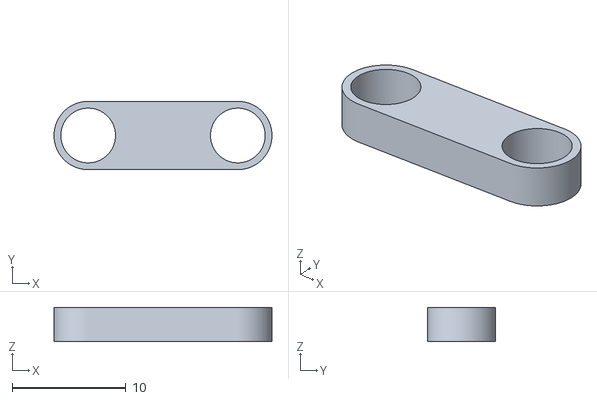
[picture p84: CAD file, 2026-10-27]
results/stl_for_print/print_ready_250mm/BARRA_00__N0-N2__13mm__capa0.stl
19.1 x 6.00 x 3.00
