SlightlyDazed/lokogad/mechanism/meshes/link_CE.step

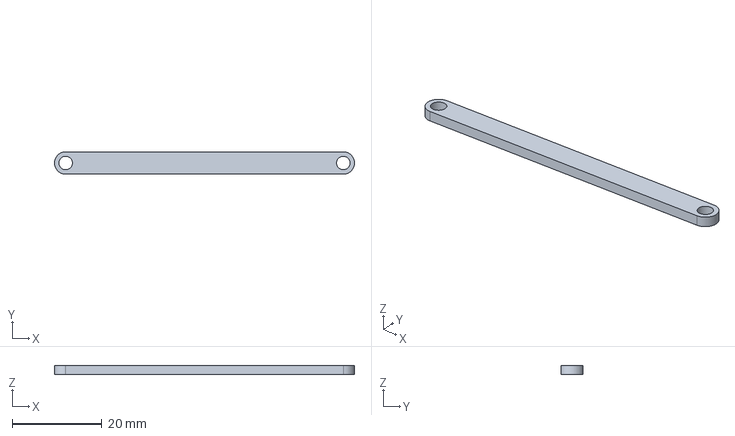
[picture p85: CAD file, 2026-10-27]
mechanism/meshes/link_CE.step
66.9 x 5.00 x 2.00 mm
