SlightlyDazed/lokogad/results/exported/candidate_001/meshes/link_BF.step

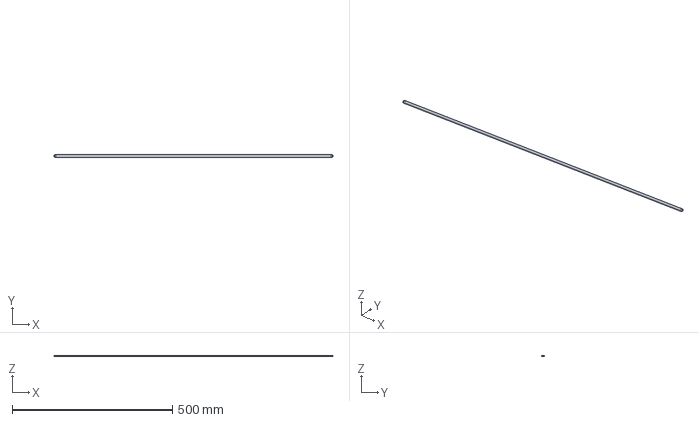
[picture p86: CAD file, 2026-10-27]
results/exported/candidate_001/meshes/link_BF.step
871.1 x 8.00 x 3.00 mm
