SlightlyDazed/lokogad/results/stl_for_print/barras_redim_1.25x/BARRA_07__N5-N6__81mm__capa+0_ESCALADA_1.25x.stl

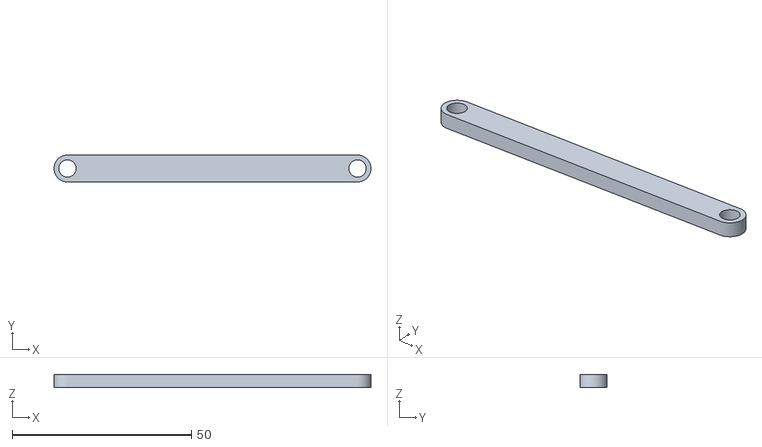
[picture p87: CAD file, 2026-10-27]
results/stl_for_print/barras_redim_1.25x/BARRA_07__N5-N6__81mm__capa+0_ESCALADA_1.25x.stl
88.4 x 7.50 x 3.75
