SlightlyDazed/lokogad/results/stl_for_print/evolved_thick/bar_03_n1-n4_L393mm_z-18mm.stl

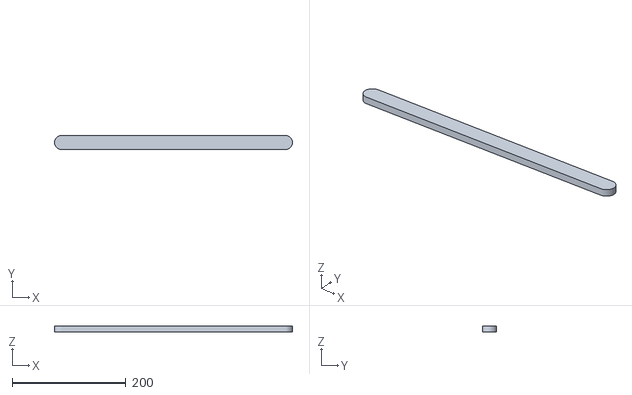
[picture p88: CAD file, 2026-10-27]
results/stl_for_print/evolved_thick/bar_03_n1-n4_L393mm_z-18mm.stl
418.2 x 25.0 x 10.0
