SlightlyDazed/lokogad/results/stl_for_print/print_ready_250mm/BARRA_01__N2-N3__84mm__capa-1.stl

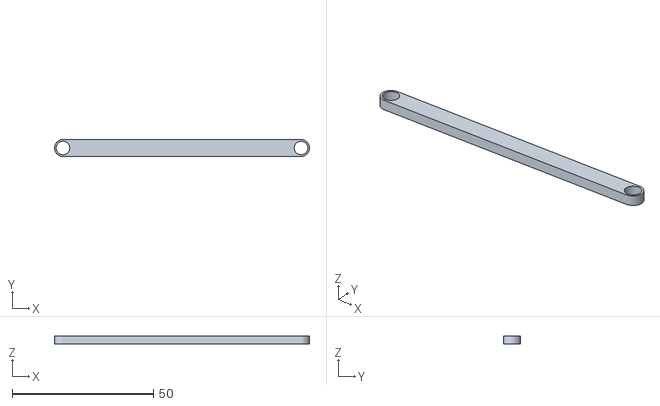
[picture p89: CAD file, 2026-10-27]
results/stl_for_print/print_ready_250mm/BARRA_01__N2-N3__84mm__capa-1.stl
90.2 x 6.00 x 3.00
