SlightlyDazed/lokogad/mechanism/meshes/chassis.step

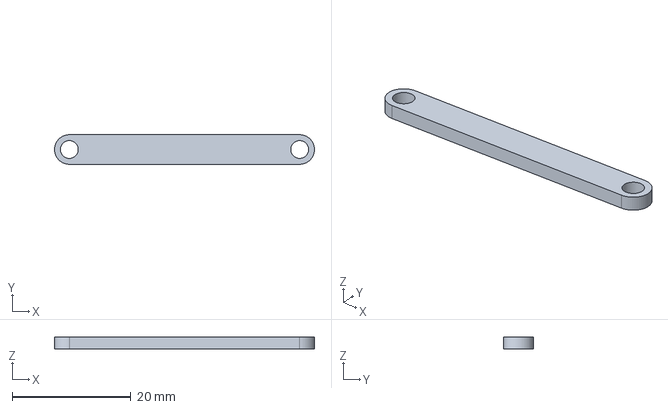
[picture p90: CAD file, 2026-10-27]
mechanism/meshes/chassis.step
43.8 x 5.00 x 2.00 mm
