SlightlyDazed/lokogad/results/exported/candidate_002/meshes/link_CD.step

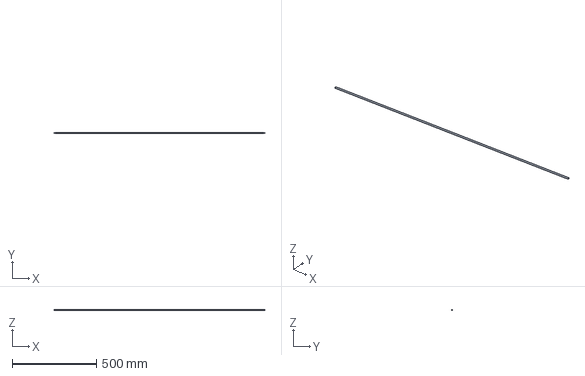
[picture p91: CAD file, 2026-10-27]
results/exported/candidate_002/meshes/link_CD.step
1249.7 x 8.00 x 3.00 mm
