SlightlyDazed/lokogad/results/stl_for_print/barras_redim_1.25x/BARRA_11__N1-N2__18mm__capa-3_ESCALADA_0.6cm.stl

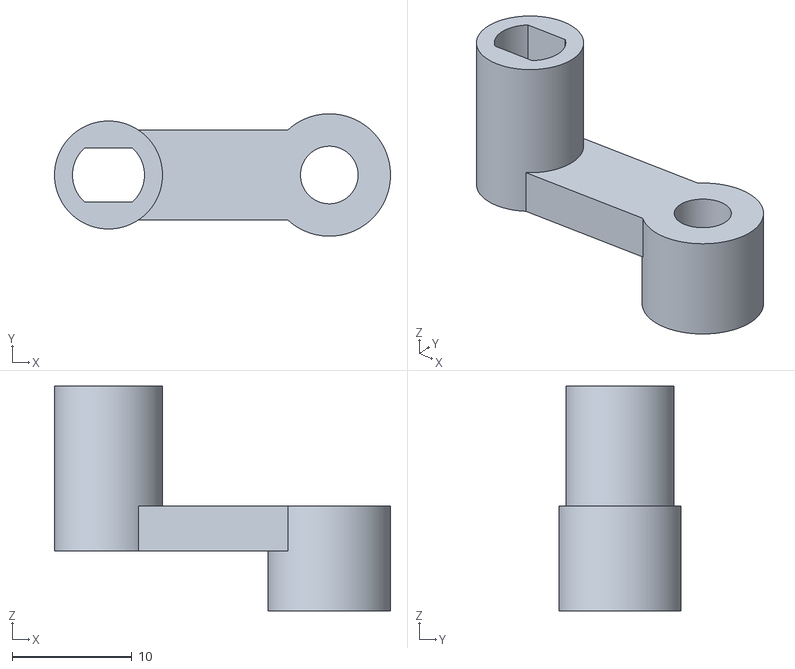
[picture p92: CAD file, 2026-10-27]
results/stl_for_print/barras_redim_1.25x/BARRA_11__N1-N2__18mm__capa-3_ESCALADA_0.6cm.stl
28.0 x 10.2 x 18.7
