SlightlyDazed/lokogad/results/stl_for_print/evolved_thick/bar_04_n2-n4_L493mm_z+18mm.stl

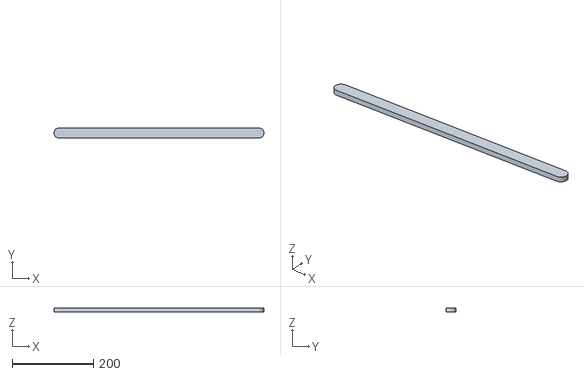
[picture p93: CAD file, 2026-10-27]
results/stl_for_print/evolved_thick/bar_04_n2-n4_L493mm_z+18mm.stl
518.1 x 25.0 x 10.0
