SlightlyDazed/lokogad/results/stl_for_print/print_ready_250mm/BARRA_08__N6-N7__92mm__capa-1.stl

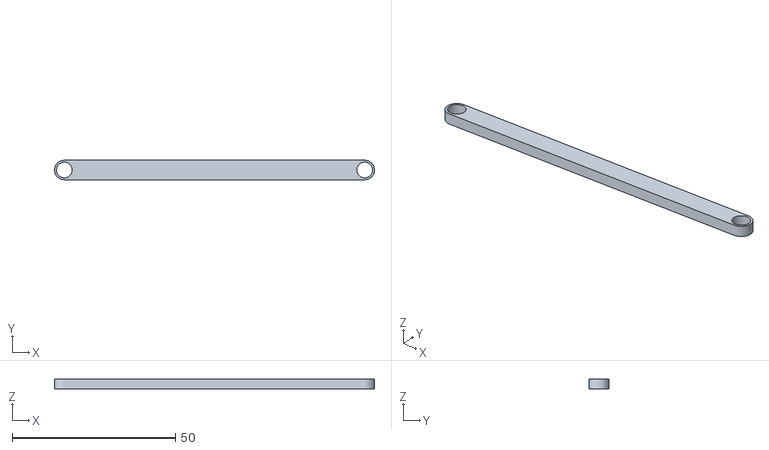
[picture p94: CAD file, 2026-10-27]
results/stl_for_print/print_ready_250mm/BARRA_08__N6-N7__92mm__capa-1.stl
98.0 x 6.00 x 3.00
