SlightlyDazed/lokogad/results/stl_for_print/barras_redim_1.25x/BARRA_05__N3-N5__117mm__capa+1_ESCALADA_1.25x.stl

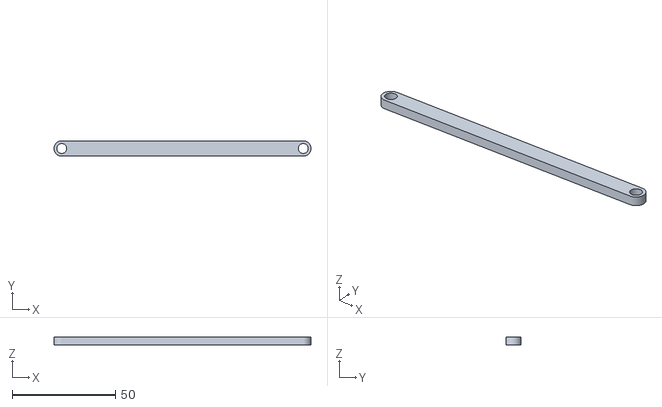
[picture p95: CAD file, 2026-10-27]
results/stl_for_print/barras_redim_1.25x/BARRA_05__N3-N5__117mm__capa+1_ESCALADA_1.25x.stl
124.6 x 7.50 x 3.75
