SlightlyDazed/lokogad/results/stl_for_print/barras_redim_1.25x/BARRA_08__N6-N7__115mm__capa-1_ESCALADA_1.25x.stl

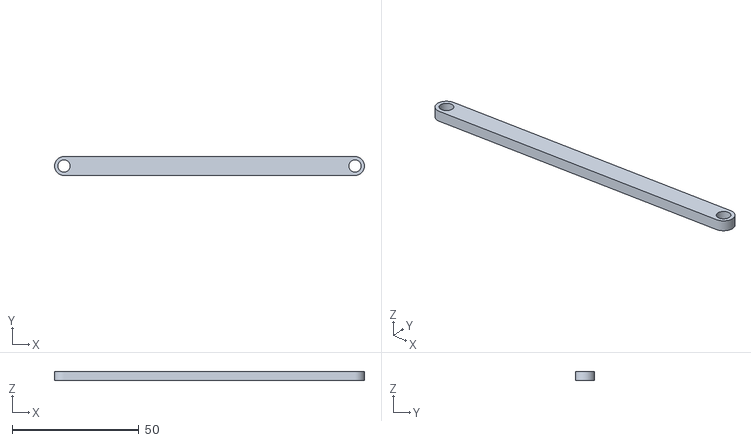
[picture p96: CAD file, 2026-10-27]
results/stl_for_print/barras_redim_1.25x/BARRA_08__N6-N7__115mm__capa-1_ESCALADA_1.25x.stl
122.5 x 7.50 x 3.75
