SlightlyDazed/lokogad/results/stl_for_print/evolved_thick/pin_05_free_h64mm_z-9mm.stl

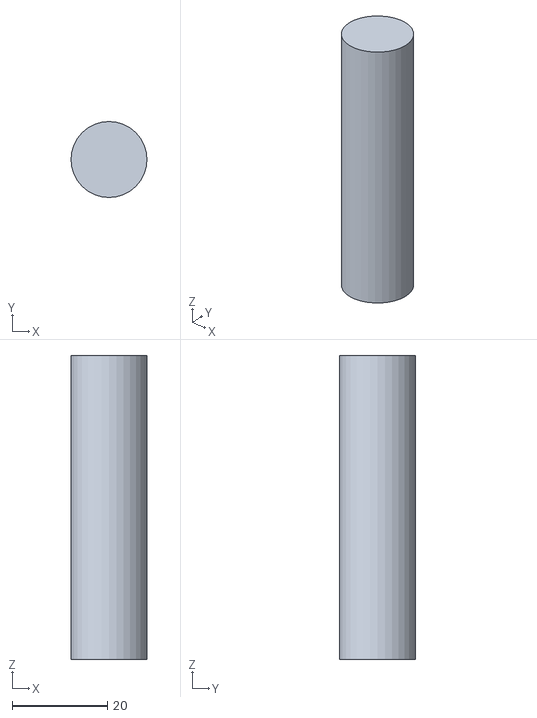
[picture p97: CAD file, 2026-10-27]
results/stl_for_print/evolved_thick/pin_05_free_h64mm_z-9mm.stl
16.0 x 16.0 x 64.0
