SlightlyDazed/lokogad/results/stl_for_print/print_ready_250mm/BARRA_02__N1-N3__73mm__capa0.stl

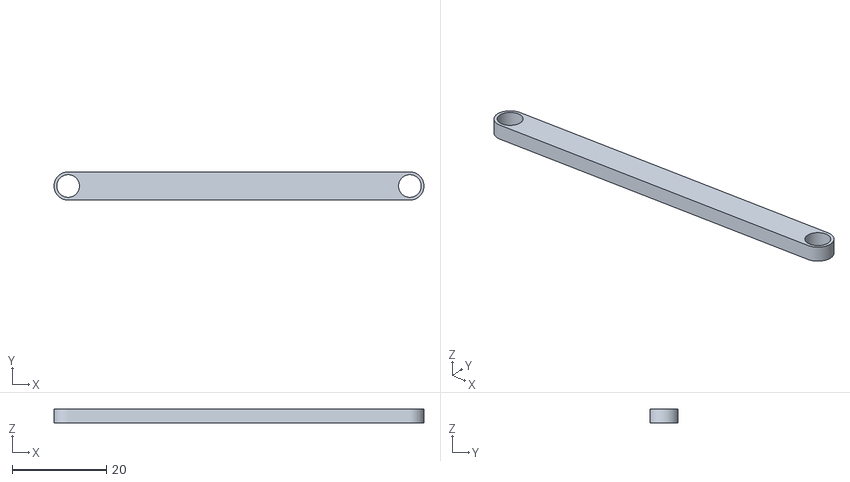
[picture p98: CAD file, 2026-10-27]
results/stl_for_print/print_ready_250mm/BARRA_02__N1-N3__73mm__capa0.stl
78.5 x 6.00 x 3.00
