SlightlyDazed/lokogad/results/stl_for_print/evolved_thick/bar_05_n3-n5_L547mm_z+18mm.stl

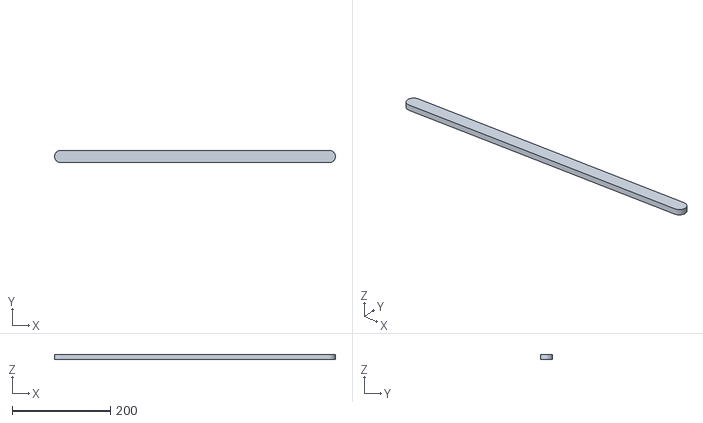
[picture p99: CAD file, 2026-10-27]
results/stl_for_print/evolved_thick/bar_05_n3-n5_L547mm_z+18mm.stl
571.9 x 25.0 x 10.0
