SlightlyDazed/lokogad/results/stl_for_print/print_ready_250mm/BARRA_04__N2-N4__85mm__capa+1.stl

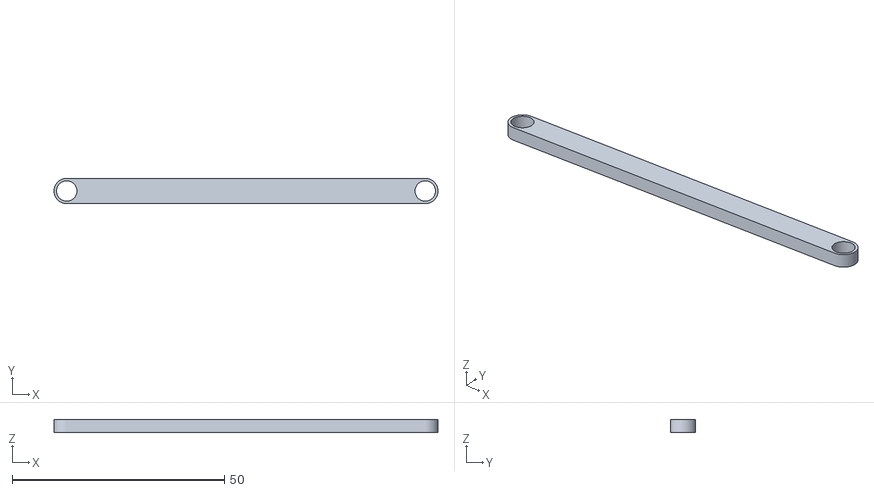
[picture p100: CAD file, 2026-10-27]
results/stl_for_print/print_ready_250mm/BARRA_04__N2-N4__85mm__capa+1.stl
90.5 x 6.00 x 3.00
