SlightlyDazed/lokogad/results/stl_for_print/print_ready_250mm/BARRA_06__N1-N5__41mm__capa-2.stl

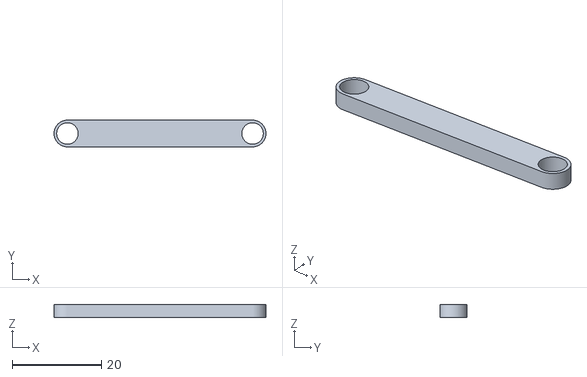
[picture p101: CAD file, 2026-10-27]
results/stl_for_print/print_ready_250mm/BARRA_06__N1-N5__41mm__capa-2.stl
47.4 x 6.00 x 3.00
