SlightlyDazed/lokogad/results/stl_for_print/evolved_thick/bar_09_n4-n7_L667mm_z+0mm.stl

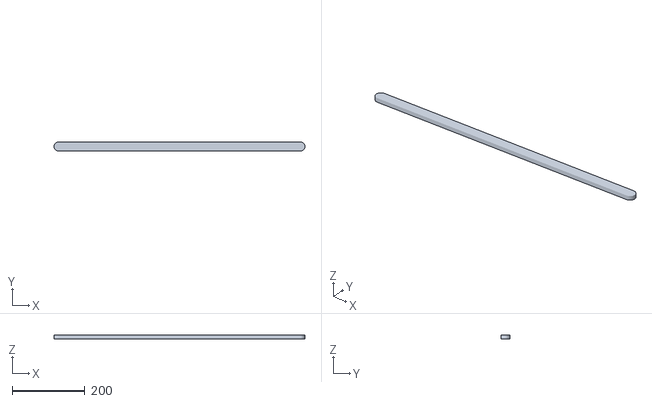
[picture p102: CAD file, 2026-10-27]
results/stl_for_print/evolved_thick/bar_09_n4-n7_L667mm_z+0mm.stl
692.2 x 25.0 x 10.0
