SlightlyDazed/lokogad/results/stl_for_print/print_ready_250mm/BARRA_09__N4-N7__114mm__capa-2.stl

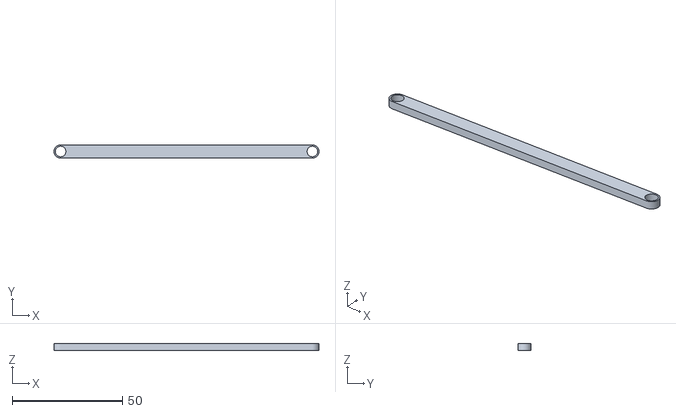
[picture p103: CAD file, 2026-10-27]
results/stl_for_print/print_ready_250mm/BARRA_09__N4-N7__114mm__capa-2.stl
120.3 x 6.00 x 3.00
