SlightlyDazed/lokogad/results/stl_for_print/evolved_thick/bar_07_n5-n6_L378mm_z+0mm.stl

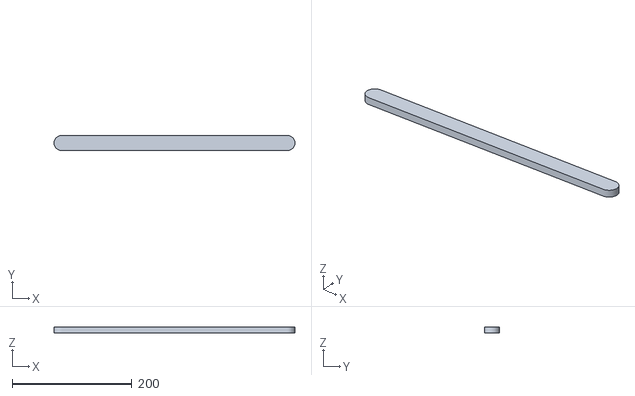
[picture p104: CAD file, 2026-10-27]
results/stl_for_print/evolved_thick/bar_07_n5-n6_L378mm_z+0mm.stl
402.6 x 25.0 x 10.0
