SlightlyDazed/lokogad/results/stl_for_print/print_ready_250mm/BARRA_07__N5-N6__65mm__capa0.stl

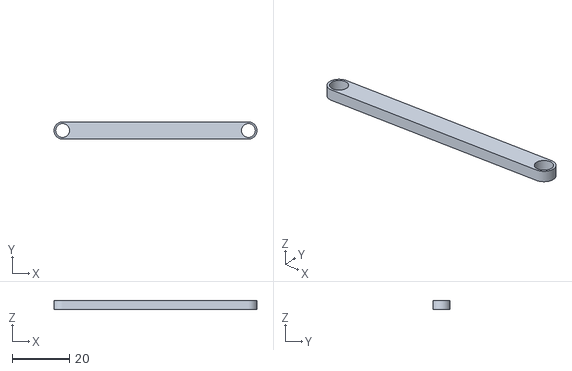
[picture p105: CAD file, 2026-10-27]
results/stl_for_print/print_ready_250mm/BARRA_07__N5-N6__65mm__capa0.stl
70.7 x 6.00 x 3.00
