SlightlyDazed/lokogad/results/stl_for_print/evolved_thick/bar_06_n1-n5_L242mm_z-36mm.stl

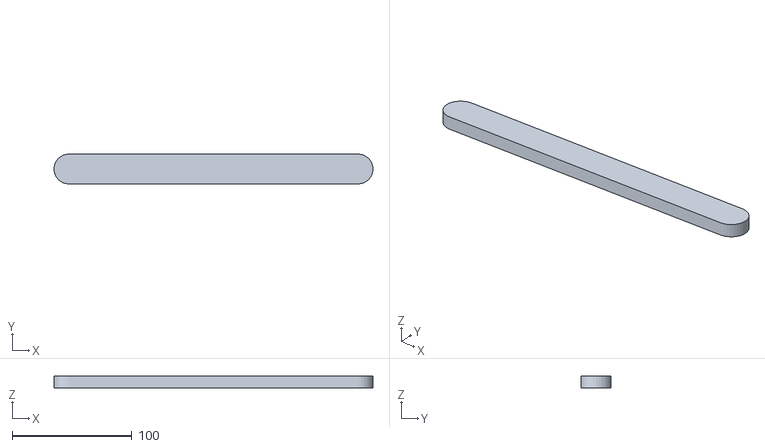
[picture p106: CAD file, 2026-10-27]
results/stl_for_print/evolved_thick/bar_06_n1-n5_L242mm_z-36mm.stl
266.9 x 25.0 x 10.0
