SlightlyDazed/lokogad/results/stl_for_print/print_ready_250mm/PIN_02__ciguenhal_motor__h36mm.stl

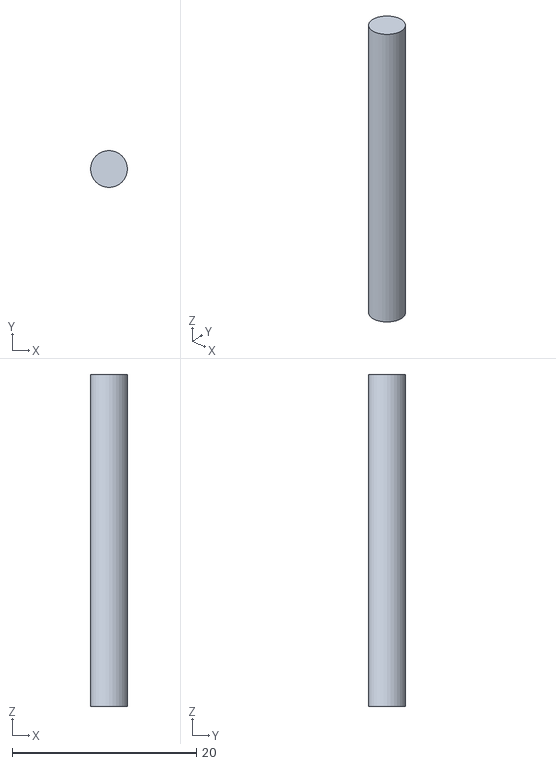
[picture p107: CAD file, 2026-10-27]
results/stl_for_print/print_ready_250mm/PIN_02__ciguenhal_motor__h36mm.stl
4.00 x 4.00 x 36.0
