SlightlyDazed/lokogad/results/stl_for_print/evolved_thick/bar_11_n1-n2_L86mm_z+36mm.stl

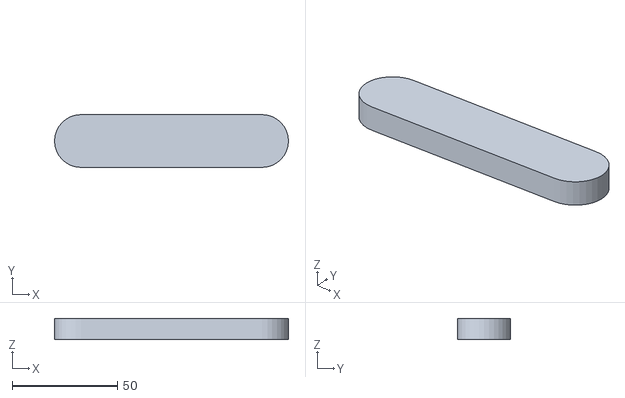
[picture p108: CAD file, 2026-10-27]
results/stl_for_print/evolved_thick/bar_11_n1-n2_L86mm_z+36mm.stl
110.9 x 25.0 x 10.0
