SlightlyDazed/lokogad/results/stl_for_print/print_ready_250mm/BARRA_03__N1-N4__67mm__capa-1.stl

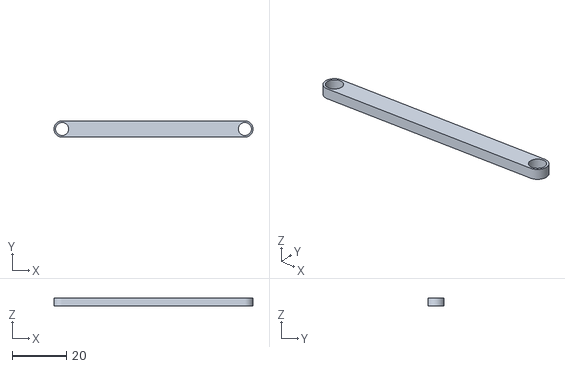
[picture p109: CAD file, 2026-10-27]
results/stl_for_print/print_ready_250mm/BARRA_03__N1-N4__67mm__capa-1.stl
73.4 x 6.00 x 3.00
