SlightlyDazed/lokogad/results/stl_for_print/evolved_thick/bar_08_n6-n7_L537mm_z-18mm.stl

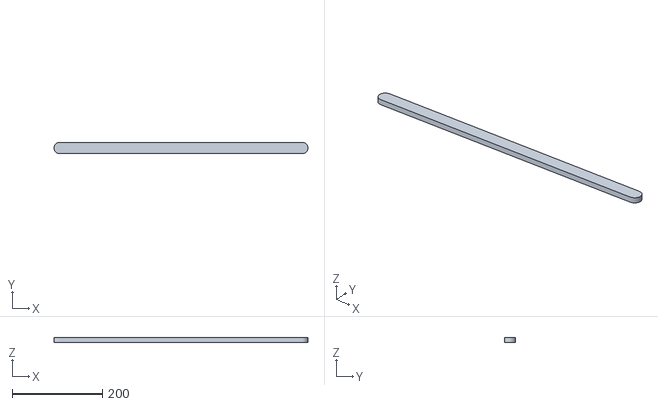
[picture p110: CAD file, 2026-10-27]
results/stl_for_print/evolved_thick/bar_08_n6-n7_L537mm_z-18mm.stl
562.1 x 25.0 x 10.0
