SlightlyDazed/lokogad/results/stl_for_print/print_ready_250mm/BARRA_10__N2-N6__110mm__capa+2.stl

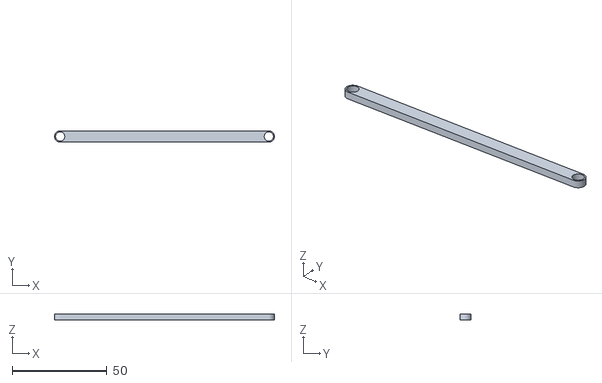
[picture p111: CAD file, 2026-10-27]
results/stl_for_print/print_ready_250mm/BARRA_10__N2-N6__110mm__capa+2.stl
115.8 x 6.00 x 3.00
