SlightlyDazed/lokogad/results/stl_for_print/print_ready_250mm/BARRA_05__N3-N5__94mm__capa+1.stl

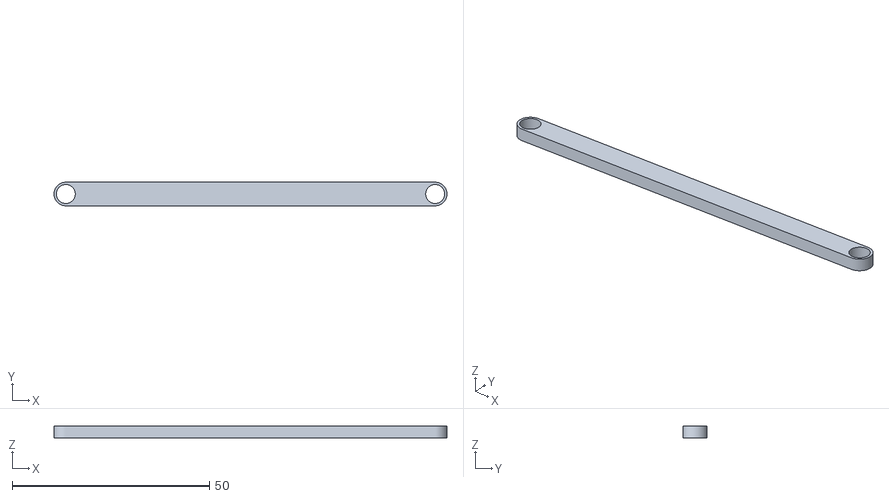
[picture p112: CAD file, 2026-10-27]
results/stl_for_print/print_ready_250mm/BARRA_05__N3-N5__94mm__capa+1.stl
99.7 x 6.00 x 3.00
