SlightlyDazed/lokogad/(list of files, cad)

Other CAD files:
results/exported/candidate_002/meshes/link_FG.step
results/exported/candidate_001/meshes/chassis.step
results/exported/candidate_002/meshes/link_DF.step
results/exported/candidate_003/meshes/link_BD.step
results/exported/candidate_004/meshes/link_BD.step
results/exported/candidate_005/meshes/link_BF.step
results/exported/candidate_001/meshes/link_DF.step
results/exported/candidate_002/meshes/link_CE.step
results/exported/candidate_003/meshes/chassis.step
results/exported/candidate_001/meshes/link_CD.step
results/exported/candidate_002/meshes/link_GH.step
results/exported/candidate_004/meshes/chassis.step
results/exported/candidate_005/meshes/link_BD.step
results/exported/candidate_001/meshes/link_BD.step
results/exported/candidate_005/meshes/link_FG.step
results/stl_for_print/print_ready_250mm/PIN_06__libre__h23mm.stl
results/exported/candidate_001/meshes/link_EG.step
results/exported/candidate_002/meshes/link_EG.step
results/exported/candidate_003/meshes/link_GH.step
results/exported/candidate_004/meshes/crank.step
results/exported/candidate_005/meshes/link_CD.step
results/stl_for_print/barras_redim_1.25x/BARRA_04__N2-N4__106mm__capa+1_ESCALADA_1.25x.stl
results/exported/candidate_001/meshes/link_CE.step
results/exported/candidate_002/meshes/link_BD.step
results/exported/candidate_003/meshes/link_BE.step
results/exported/candidate_004/meshes/link_GH.step
results/exported/candidate_005/meshes/crank.step
results/exported/candidate_001/meshes/link_EH.step
results/exported/candidate_002/meshes/link_BF.step
results/exported/candidate_003/meshes/link_EH.step
results/exported/candidate_004/meshes/link_EH.step
results/exported/candidate_002/meshes/chassis.step
results/exported/candidate_003/meshes/link_CE.step
results/exported/candidate_004/meshes/link_FG.step
results/exported/candidate_005/meshes/link_EH.step
results/exported/candidate_001/meshes/link_GH.step
results/exported/candidate_003/meshes/crank.step
results/exported/candidate_004/meshes/link_CD.step
results/exported/candidate_005/meshes/link_CE.step
mechanism/meshes/link_FG.step
results/exported/candidate_001/meshes/link_BE.step
results/exported/candidate_002/meshes/link_BE.step
results/exported/candidate_003/meshes/link_DF.step
results/exported/candidate_004/meshes/link_DF.step
results/exported/candidate_005/meshes/link_GH.step
results/stl_for_print/print_ready_250mm/PIN_01__suelo_fijo__h23mm.stl
results/stl_for_print/evolved_thick/pin_06_free_h46mm_z-18mm.stl
mechanism/meshes/chassis.stl
mechanism/meshes/crank_AC.stl
mechanism/meshes/link_BD.stl
mechanism/meshes/link_BE.stl
mechanism/meshes/link_BF.stl
mechanism/meshes/link_CD.stl
mechanism/meshes/link_CE.stl
mechanism/meshes/link_DF.stl
mechanism/meshes/link_EG.stl
mechanism/meshes/link_EH.stl
mechanism/meshes/link_FG.stl
mechanism/meshes/link_GH.stl
results/exported/candidate_001/meshes/chassis.stl
results/exported/candidate_001/meshes/crank.stl
results/exported/candidate_001/meshes/link_BD.stl
results/exported/candidate_001/meshes/link_BE.stl
results/exported/candidate_001/meshes/link_BF.stl
results/exported/candidate_001/meshes/link_CD.stl
results/exported/candidate_001/meshes/link_CE.stl
results/exported/candidate_001/meshes/link_DF.stl
results/exported/candidate_001/meshes/link_EG.stl
results/exported/candidate_001/meshes/link_EH.stl
results/exported/candidate_001/meshes/link_FG.stl
results/exported/candidate_001/meshes/link_GH.stl
results/exported/candidate_002/meshes/chassis.stl
results/exported/candidate_002/meshes/crank.stl
results/exported/candidate_002/meshes/link_BD.stl
results/exported/candidate_002/meshes/link_BE.stl
results/exported/candidate_002/meshes/link_BF.stl
results/exported/candidate_002/meshes/link_CD.stl
results/exported/candidate_002/meshes/link_CE.stl
results/exported/candidate_002/meshes/link_DF.stl
results/exported/candidate_002/meshes/link_EG.stl
results/exported/candidate_002/meshes/link_EH.stl
results/exported/candidate_002/meshes/link_FG.stl
results/exported/candidate_002/meshes/link_GH.stl
results/exported/candidate_003/meshes/chassis.stl
results/exported/candidate_003/meshes/crank.stl
results/exported/candidate_003/meshes/link_BD.stl
results/exported/candidate_003/meshes/link_BE.stl
results/exported/candidate_003/meshes/link_BF.stl
results/exported/candidate_003/meshes/link_CD.stl
results/exported/candidate_003/meshes/link_CE.stl
results/exported/candidate_003/meshes/link_DF.stl
results/exported/candidate_003/meshes/link_EG.stl
results/exported/candidate_003/meshes/link_EH.stl
results/exported/candidate_003/meshes/link_FG.stl
results/exported/candidate_003/meshes/link_GH.stl
results/exported/candidate_004/meshes/chassis.stl
results/exported/candidate_004/meshes/crank.stl
results/exported/candidate_004/meshes/link_BD.stl
results/exported/candidate_004/meshes/link_BE.stl
results/exported/candidate_004/meshes/link_BF.stl
results/exported/candidate_004/meshes/link_CD.stl
results/exported/candidate_004/meshes/link_CE.stl
results/exported/candidate_004/meshes/link_DF.stl
results/exported/candidate_004/meshes/link_EG.stl
results/exported/candidate_004/meshes/link_EH.stl
results/exported/candidate_004/meshes/link_FG.stl
results/exported/candidate_004/meshes/link_GH.stl
results/exported/candidate_005/meshes/chassis.stl
results/exported/candidate_005/meshes/crank.stl
results/exported/candidate_005/meshes/link_BD.stl
results/exported/candidate_005/meshes/link_BE.stl
results/exported/candidate_005/meshes/link_BF.stl
results/exported/candidate_005/meshes/link_CD.stl
results/exported/candidate_005/meshes/link_CE.stl
results/exported/candidate_005/meshes/link_DF.stl
results/exported/candidate_005/meshes/link_EG.stl
results/exported/candidate_005/meshes/link_EH.stl
results/exported/candidate_005/meshes/link_FG.stl
results/exported/candidate_005/meshes/link_GH.stl
snap_joint/link_A.stl
snap_joint/link_B.stl
