SlightlyDazed/lokogad/results/diagnostic_trajectories.png

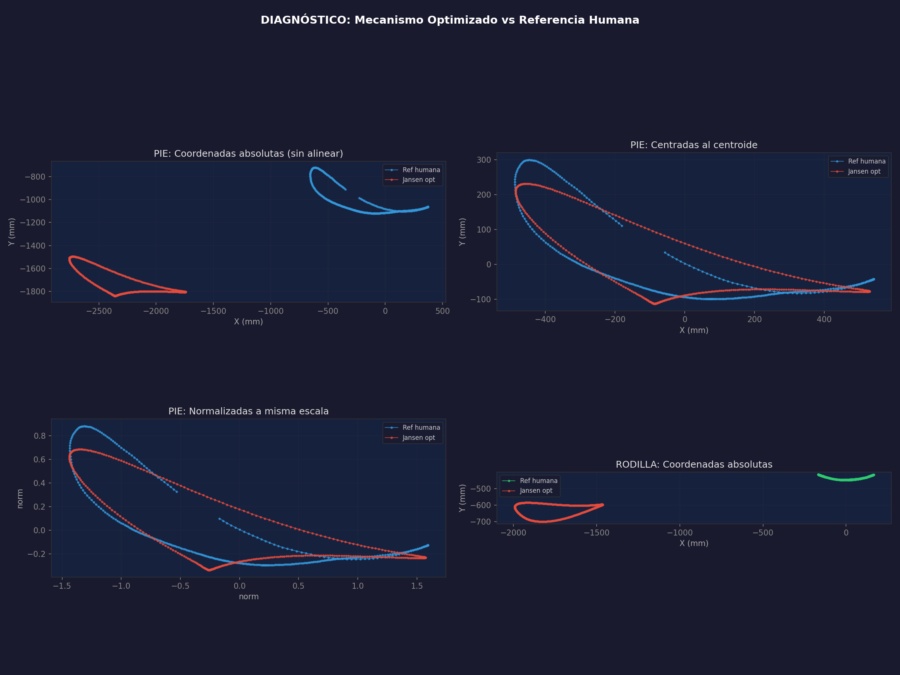
results/diagnostic_trajectories.png
