SlightlyDazed/lokogad/results/diagnostic_v2.png

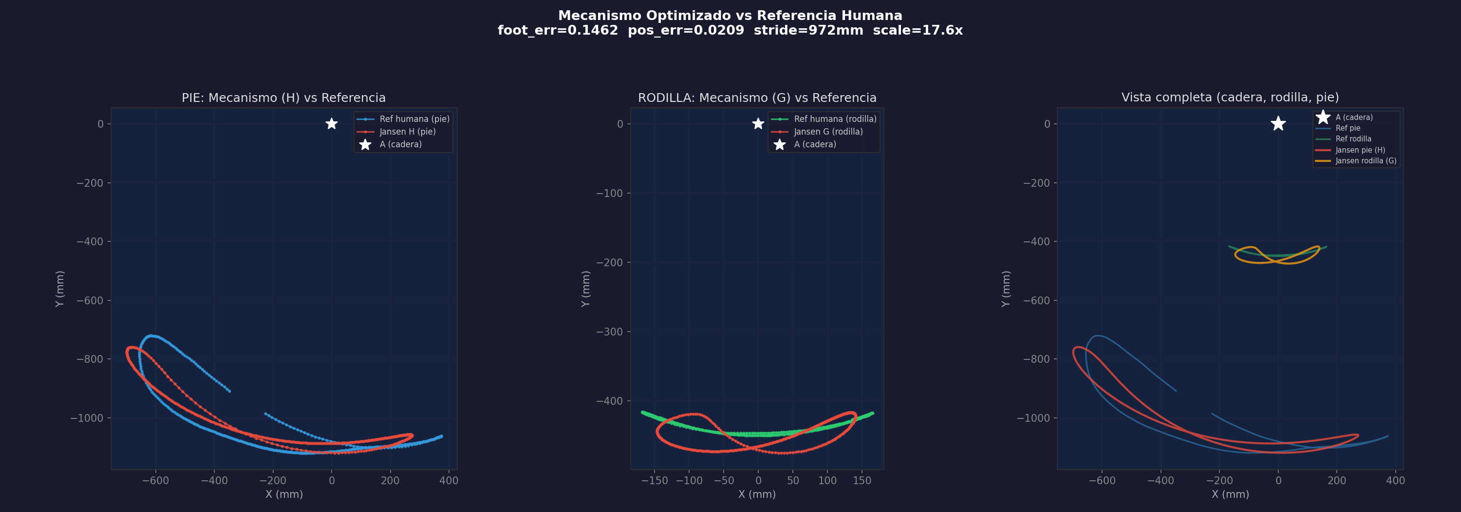
results/diagnostic_v2.png
