SlightlyDazed/lokogad/results/exported/candidate_001/comparison.png

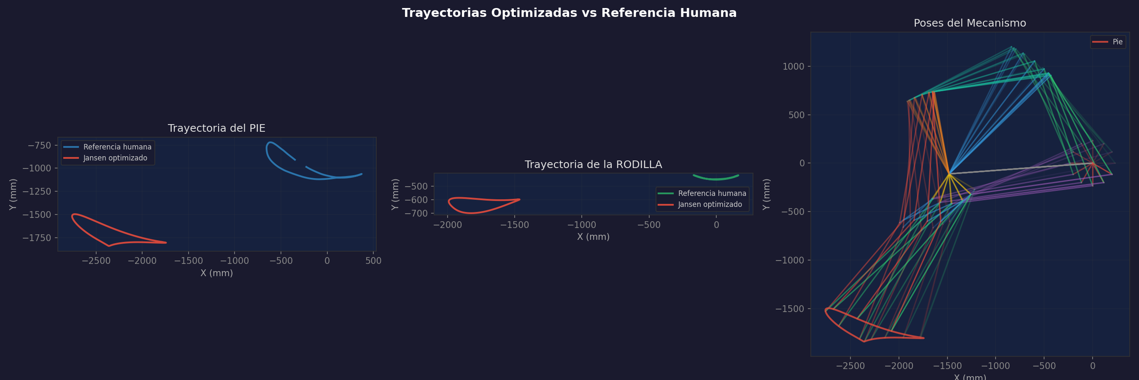
results/exported/candidate_001/comparison.png
