SlightlyDazed/lokogad/results/plots/ref_trajectories_pt.png

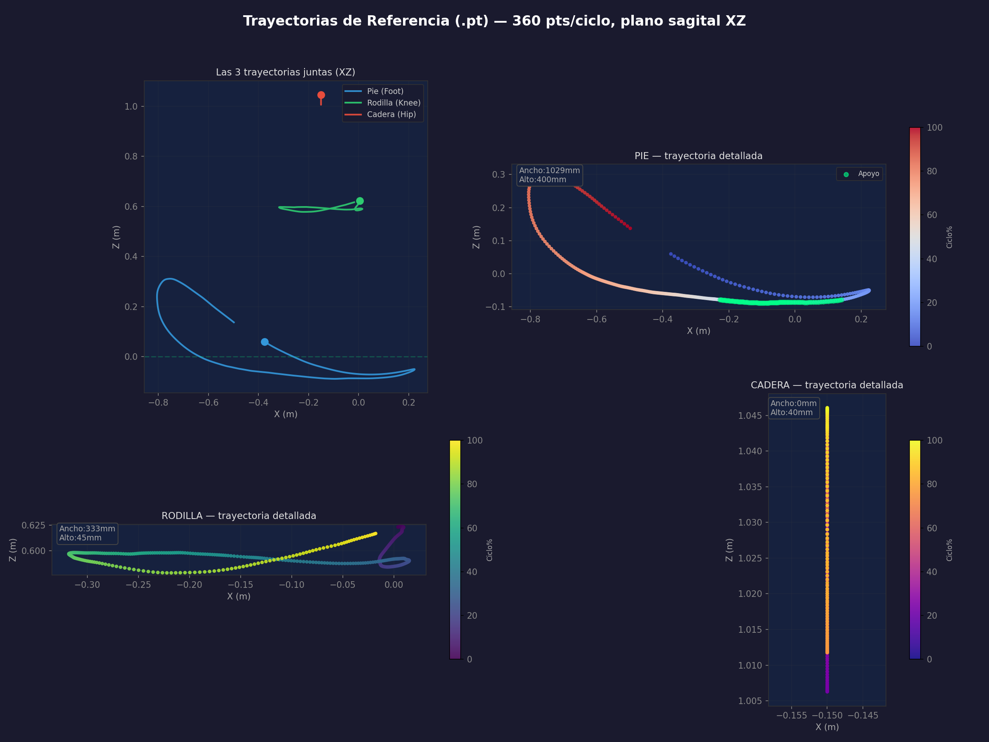
results/plots/ref_trajectories_pt.png
