SlightlyDazed/lokogad/(commit log)

2026-10-27 Initial public version
    [BARRA_00__N0-N2__13mm__capa0.stl, BARRA_00__N0-N2__16mm__capa+0_ESCALADA_1.25x.stl, BARRA_01__N2-N3__105mm__capa-1_ESCALADA_1.25x.stl, BARRA_01__N2-N3__84mm__capa-1.stl, BARRA_02__N1-N3__73mm__capa0.stl, BARRA_02__N1-N3__91mm__capa+0_ESCALADA_1.25x.stl, BARRA_03__N1-N4__67mm__capa-1.stl, BARRA_03__N1-N4__84mm__capa-1_ESCALADA_1.25x.stl]
2026-10-28 docs: redesign README and fix GIF first frame
    - New banner, badges and navigation in the style of the OpenKick README
    - Prototype photos (front, side, three-quarter) in docs/images/
    - Clips from the presentation video as GIFs: OpenSim gait, evolution,
    assembly and the running mechanism
    - 2x2 gallery of the 3D gait GIFs, results figure, scope callout and BibTeX
    - Remove the black first frame from the four gait GIFs in visualization/gifs/
2026-11-05 Fix Procrustes rotation and add shape/position analysis
    - core/config_jansen.py: _procrustes_rotation returned the transpose of the
    optimal rotation (V D U^T instead of U D V^T for row-vector points), so curves
    were rotated by -theta instead of +theta. Verified on synthetic rotations.
    - analysis/shape_fit.py: fits each mechanism trajectory onto the human
    reference (centre, scale, phase, rotation limited to +/-30 deg) with one
    mirror choice per mechanism, and reports shape and position errors.
    - opensim_extraction/*_fourier_tensor.pt: Fourier-smoothed references (H = 7).
    - README: single double-shaft motor, updated results and a note on the
    pending re-run of the searches.
    Co-Author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
2026-11-05 Show the measured stance fraction in the gait figure legend
    The legend of snapshot_gait_figure.py printed a fixed "55% / 45%".
    It now prints the fraction of the cycle inside the stance band used by
    the script (78% / 22% for the final mechanism).
    Claude-Session: https://claude.ai/code/session_019u3BkRsjjNFHCYn8XYbLVU
